DreamPawaret/GPS-Mobile-Robot-Project/project/6710.contentimage_5F00_112868.webp

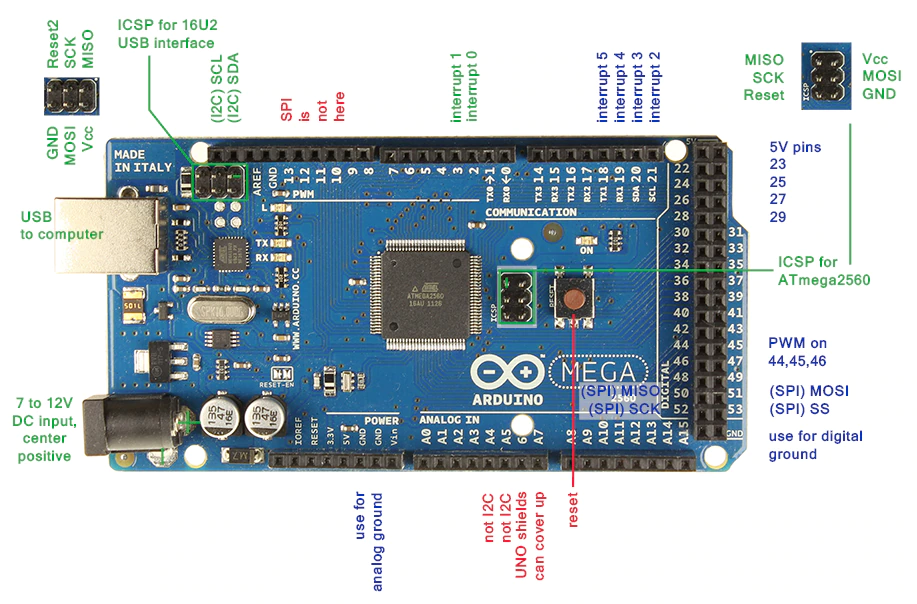
project/6710.contentimage_5F00_112868.webp
