DreamPawaret/GPS-Mobile-Robot-Project/project/รายงานความก้าวหน้า/complete report/GPS_mobile_robot.pdf

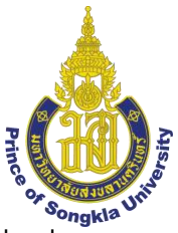
[picture p2: figure]

หุ่นยนต์เคลื่อนที่ควบคุมด้วยระบบ GPS GPS Mobile Robot

นายปวเรศ ปิ่นแก้ว
6010110680

โครงงานวิศวกรรมคอมพิวเตอร์นี้เป็นส่วนหนึ่งของการศึกษาตามหลักสูตรปริญญา วิศวกรรมศาสตร์บัณฑิต สาขาวิชาวิศวกรรมคอมพิวเตอร์ ภาควิชาวิศวกรรมคอมพิวเตอร์ คณะวิศวกรรมศาสตร์ มหาวิทยาลัยสงขลานครินทร์ 2565

ก

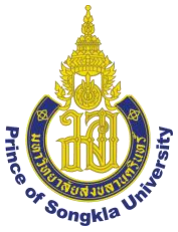
[picture p3: figure]

หุ่นยนต์เคลื่อนที่ควบคุมด้วยระบบ GPS GPS Mobile Robot

นายปวเรศ ปิ่นแก้ว
6010110680

โครงงานวิศวกรรมคอมพิวเตอร์นี้เป็นส่วนหนึ่งของการศึกษาตามหลักสูตรปริญญา วิศวกรรมศาสตร์บัณฑิต สาขาวิชาวิศวกรรมคอมพิวเตอร์ ภาควิชาวิศวกรรมคอมพิวเตอร์ คณะวิศวกรรมศาสตร์ มหาวิทยาลัยสงขลานครินทร์ 2565

ข

ชื่อโครงงาน | หุ่นยนต์เคลื่อนที่ควบคุมด้วยระบบ GPS
ผู้จัดท า | นายปวเรศ ปิ่นแก้ว | รหัสนักศึกษา | 6010110680
สาขาวิชา | วิศวกรรมคอมพิวเตอร์
ปีการศึกษา | 2565
อาจารย์ที่ปรึกษาโครงงาน | คณะกรรมการสอบ
(ผศ.ดร.ธเนศ เคารพาพงศ์) | (ดร.สมชัย หลิมศิโรรัตน์)
| (ดร.อนันต์ ชกสุริวงค์)
| (ผศ.ดร.นิคม สุวรรณวร)
| (ผศ.ดร.ธเนศ เคารพาพงศ์)

โครงงานนี้เป็นส่วนหนึ่งของรายวิชาโครงงานวิศวกรรมคอมพิวเตอร์ 1 และ 2 ตามหลักสูตร ปริญญาวิศวกรรมศาสตร์บัณฑิต สาขาวิชาวิศวกรรมคอมพิวเตอร์ มหาวิทยาลัยสงขลานครินทร์

(รศ.ดร.พิชญา ตัณฑัยย์)
รักษาการในหัวหน้าสาขาวิชาวิศวกรรมคอมพิวเตอร์

ค

หนังสือรับรองความเป็นเอกลักษณ์ ข้าพเจ้าผู้ลงนามท้ายนี้ ขอรับรองว่ารายงานฉบับนี้เป็นรายงานที่มีความเป็นเอกลักษณ์ โดยที่ ข้าพเจ้ามิได้มีการคัดลอกมาจากที่ใด เนื้อหาในรายงานทั้งหมดถูกรวบรวมจากการพัฒนาในขั้นตอน ต่าง ๆ ของการจัดท าโครงงาน หากส่วนใดที่จ าเป็นต้องน าข้อความจากผลงานของบุคคลอื่นใดที่ไม่ใช่ ตัวข้าพเจ้า ข้าพเจ้าได้ท าการอ้างอิงถึงเอกสารเหล่านั้นไว้อย่างเหมาะสม และขอรับรองว่ารายงาน ฉบับนี้ไม่เคยเสนอต่อสถาบันใดมาก่อน

ผู้จัดท า

(นายปวเรศ ปิ่นแก้ว)

ง

ชื่อโครงงาน | หุ่นยนต์เคลื่อนที่ควบคุมด้วยระบบ GPS
ผู้จัดท า | นายปวเรศ ปิ่นแก้ว | รหัสนักศึกษา | 6010110680
สาขาวิชา | วิศวกรรมคอมพิวเตอร์
ปีการศึกษา | 2565

บทคัดย่อ
เนื้อความบทคัดย่อ
โครงงานหุ่นยนต์เคลื่อนที่ควบคุมด้วยระบบ GPS เป็นโครงงานที่พัฒนาขึ้นเพื่อน าระบบระบุ ต าแหน่งบนโลก(GPS) มาประยุกต์ใช้กับหุ่นยนต์ โดยใช้การระบุพิกัดของ GPS ในการก าหนดพิกัดที่ ต้องการให้หุ่นยนต์เคลื่อนที่ไป เพื่อน าไปประยุกต์ในการใช้งานต่างๆภายนอกอาคาร เช่น การ ส่งพัสดุ หรือการส ารวจพื้นที่ โดยจะใช้หุ่นยนต์เคลื่อนที่อย่างง่าย ที่มีบอร์ด Arduino เป็นตัวหลักในการ ควบคุม สั่งการเซ็นเซอร์และการท างานของหุ่นยนต์เพื่อให้หุ่นยนต์เคลื่อนที่ไปโดยอัตโนมัติ

ค าส าคัญ ระบบระบุต าแหน่งบนโลก(GPS) มุมทิศ Haversine formular Azimuth formular

จ

Project | GPS Mobile Robot
Author | Mr. Pawaret Pinkaew Student ID | 6010110680
Major Program | Computer Engineering
Academic Year | 2022

Abstract
Description
GPS Mobile Robot is a project developed to apply global positioning system (GPS) to robots, using GPS coordinates to determine the target location that you want the robot to move. To be used in various applications outside the building such as parcel delivery or surveying the area, using a simple mobile robot that has an Arduino board as the main control and command the robot's sensors and actions to make the robot move automatically.

Keyword Global Positioning System (GPS) Azimuth angle Haversine formular
Azimuth formular

ฉ

กิตติกรรมประกาศ
โครงงานนี้ส าเร็จลุล่วงได้ด้วยความกรุณาจาก ผศ.ดร.ธเนศ เคารพาพงศ์ อาจารย์ที่ปรึกษา โครงงานที่ได้ให้ค าเสนอแนะ แนวคิด ตลอดจนการแก้ไขข้อบกพร่องต่าง ๆ มาโดยตลอดจนโครงงาน เล่มนี้เสร็จสมบูรณ์ ผู้จัดท าจึงขอกราบขอบพระคุณเป็นอย่างสูง
ขอบพระคุณ ผศ.ดร.นิคม สุวรรณวร ดร.อนันท์ ชกสุริวงค์ และ ดร.สมชัย หลิมศิโรรัตน์ ที่ให้ ค าแนะน าและข้อคิดต่ าง ๆ ในการจัดท าโครงงานฉบับนี้
ขอบพระคุณ คุณอนันต์ นิลโกสีย์ ที่ให้ค าแนะน าในการใช้งานเครื่องมือช่าง การเลือกวัสดุ และอุปกรณ์ที่ใช้งานในโครงงานและออ านวยความสะดวกในการใช้งานเครื่องมือ ขอบพระคุณคุณวิมล ค าจันทร์ คุณบงกช พฤกษพงษ์ที่อ านวยความสะดวกและค าปรึกษาใน การลงทะเบียนเรียนรายและการสอบวิชาโครงงาน
ขอบพระคุณผู้ปกครอง ที่ให้การสนับสนุน และขอขอบคุณพี่ๆรวมทั้งเพื่อน ๆ ที่ให้ความ ช่วยเหลือและให้ค าปรึกษาแนวท างในก ารท าโครงงานนี้

ปวเรศ ปิ่นแก้ว

ช

สารบัญ
หนังสือรับรองความเป็นเอกลักษณ์ | ค
บทคัดย่อ | ง
Abstract | จ
กิตติกรรมประกาศ | ฉ
สารบัญ | ช
สารบัญรูปภาพ | ญ
สารบัญตาราง | ฎ

ซ

ฌ

ญ

สารบัญรูปภาพ

ฎ

สารบัญตาราง

บทที่1
บทน า
ที่มาและความส าคัญ
ปัจจุบันหุ่นยนต์เริ่มเข้ามามีบทบาทในกิจกรรมต่างๆของมนุษย์มากขึ้น จึงมีการพัฒนาอย่าง รวดเร็วและ กว้างขวาง เพื่อช่วยแบ่งเบาภาระการท างานหรือเพิ่มประสิทธิภาพในการท างาน เช่น หุ่นยนต์บริการในร้านอาหาร BellaBot [1] ท าหน้าที่ให้บริการต้อนรับลูกค้า รับออร์เดอร์ และเสิร์ฟ อาหาร ซึ่งหุ่นยนต์ตัวนี้มีการใช้ AI ในการควบคุมเซ็นเซอร์หลายๆตัวเช่น การตรวจสอบการเคลื่อนไหว การระบุต าแหน่งภายในร้าน หากกล่าวถึงการระบุต าแหน่งแล้ว เทคโนโลยีที่มีความสามารถในการ ระบุต าแหน่งได้อย่างแม่นย าในปัจจุบันก็คือระบบ Global Positioning System (GPS) ซึ่งสามารถ น ามาประยุกต์ใช้เพื่อให้เกิดประโยชน์มากมายไม่ว่าจะ เป็น การท าแผนที่ ระบบน าร่อง หรือการ ติดตามยานพาหนะ อีกทั้งยังเป็นระบบที่ทุกคนสามารถเข้าถึงและใช้งาน ได้ง่าย ผู้จัดท าจึงมีความ สนใจที่จะน าระบบ GPS มาประยุกต์ใช้กับหุ่นยนต์ โดยใช้การระบุพิกัดของระบบ GPS มา ใช้ในการ ควบคุมทิศทางการเคลื่อนที่ของหุ่นยนต์เพื่อน าไปประยุกต์ในการใช้งานต่างๆภายนอกอาคาร เช่น การ ส่งพัสดุหรือการส ารวจพื้นที่ โดยจะใช้หุ่นยนต์เคลื่อนที่อย่างง่าย ที่มีบอร์ด Arduino เป็นตัวหลักใน การควบคุม และสั่งการเซ็นเซอร์ต่างๆของหุ่นยนต์

วัตถุประสงค์ของโครงงาน
1. เพื่อสร้างหุ่นยนต์ที่สามารถเคลื่อนที่ได้อัตโนมัติโดยใช้การระบุพิกัดด้วย GPS เป็นตัวควบคุม
2. เพื่อสร้างโปรแกรมในการก าหนดต าแหน่งเพื่อให้หุ่นยนต์เคลื่อนที่

ประโยชน์ที่คาดว่าจะได้รับ
1. สามารถสร้างหุ่นยนต์ที่สามารถเคลื่อนที่ได้อัตโนมัติตามต าแหน่งที่ระบุด้วยพิกัดจาก GPS ได้
2. สามารถสร้างโปรแกรมส าหรับการระบุต าแหน่งที่ต้องการให้หุ่นยนต์เคลื่อนที่ไปได้
3. สามารถน าการระบุพิกัด GPS ไปใช้ในการควบคุมทิศทางการเคลื่อนที่ของหุ่นยนต์ได้

ขอบเขตของโครงงาน
1. หุ่นยนต์สามารถเคลื่อนที่ได้ตามต าแหน่งที่ระบุบน GPS
2. หุ่นยนต์สามารถหลบสิ่งกีดขวางขนาดเล็กที่หยุดนิ่งได้
3. สามารถค านวณระยะทางและความเร็วในการเคลื่อนที่ศึกของหุ่นได้

แผนการด าเนินงาน
ขั้นตอนการด าเนินการ | Project Preparation (2/63) | Project I (1/64) | Project II (1/65)
ธ.ค. | ม.ค. | ก.พ. | มี.ค. | เม.ย. | มิ.ย. | ก.ค. | ส.ค. | ก.ย. | ต.ค. | มิ.ย. | ก.ค. | ส.ค. | ก.ย. | ต.ค.
1.ศึกษาหัวข้อโครงงาน
2.ศึกษางานวิจัยและเอกสารที่เกี่ยวข้องกับโครงงาน 3.ศึกษาระบบ GPS และระบบควบคุมที่ใช้ GPS 4.ศึกษาการท างานของอุปกรณ์และเซ็นเซอร์ต่างๆ ที่ใช้ในโครงงาน

5.ศึกษาการเขียนโปรแกรมส าหรับควบคุม microcontroller

6.ออกแบบหุ่นยนต์และระบบการท างาน 7.ออกแบบโปรแกรมและเขียนโปรแกรมส าหรับการท างาน ของ Microcontroller

8.พัฒนาหุ่นยนต์และเขียนโปรแกรมส าหรับควบคุม Microcontroller

9.ทดลองและวัดผลการทดลอง
10.สรุปผลการทดลอง
11.จัดท าเล่มโครงงาน
ตารางที่ 1 แผนการด าเนินงาน

บทที่2
ทฤษฎีและความรู้พื้นฐาน
GPS
GPS ย่อมาจาก Global Positioning System หรือระบบระบุต าแหน่งบนพื้นโลก โดยอาศัย ดาวเทียม ซึ่งโคจรอยู่รอบโลก ดาวเทียมดวงหนึ่งโคจรรอบโลก 1 รอบ ใช้เวลา 12 ขั่วโมง ระบบ GPS ท างานโดยการรับสัญญาณจากดาวเทียม ซึ่งประกอบไปด้วยประกอบไปด้วยข้อมูลที่ระบุต าแหน่งและ เวลาขณะส่งสัญญาณ เครื่องรับสัญญาณดาวเทียมจะค านวนระยะทางระหว่างดาวเทียมและเครื่องรับ สัญญาณ เพื่อความแม่นย าในการค านวณต าแหน่ง ต้องใช้ดาวเทียมอย่างน้อย 4 ดวง นอกจากนี้ความ แม่นย าของการระบุต าแหน่งนั้นขึ้นอยู่กับต าแหน่งของดาวเทียมแต่ละดวง ความแปรปรวนของชั้น บรรยากาศ และสิ่งแวดล้อมในบริเวณรับสัญญาณ [2][3]
ส่วนการควบคุมการน าทางของหุ่นยนต์

### 2.2.1 เครื่องรับสัญญาณ GPS GY-NEO6MV2

โมดูล GPS GY-NEO6MV2 เป็นโมดูล U-blox รุ่น NEO-6M สามารถเชื่อมต่อได้กับ ไมโครคอนโทรลเลอร์หลายหลายประเภทไม่ว่าจะเป็น Arduino, NodeMCU, Raspberry Pi, ESP32 ผ่านทาง Serial UART ความเร็วที่ 9600 (สามารถเพิ่มได้) และต าแหน่งอัพเดทตลอดทุกๆ 1 วินาที สามารถตั้งค่าให้เร็วกว่านี้ได้ การท างานเมื่อตัวโมดูลจับสัญญาณได้จะขึ้นไฟสีเขียวกระพริบ ตัวโมดูลมี แบตเตอรี่เก็บต าแหน่งล่าสุดและคอนฟิกต่างๆ โดยจะมีความแม่นย าของพิกัดอยู่ที่ 2.5 CEP หรือก็คือ ภายในรัศมี 2.5 เมตร [4]

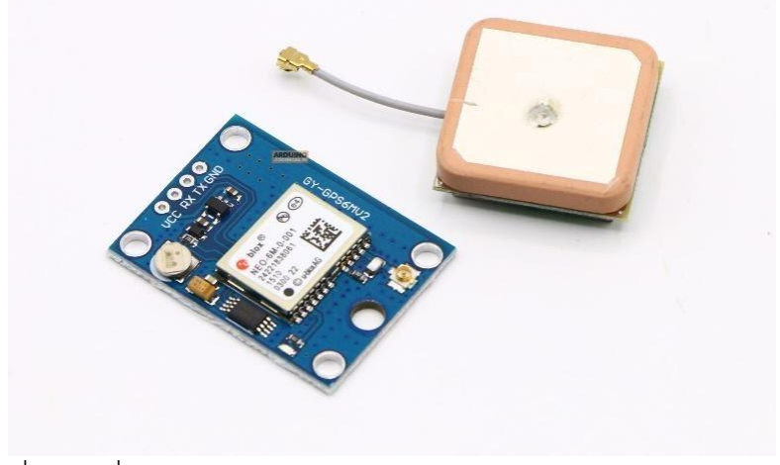
[picture p4: figure]

รูปที่ 1 เครื่องรับสัญญาณ GPS GY-NEO6MV2 และเสาอากาศ [5]

### 2.2.2 GY-273 3-axis Compass Module (HMC5883L)

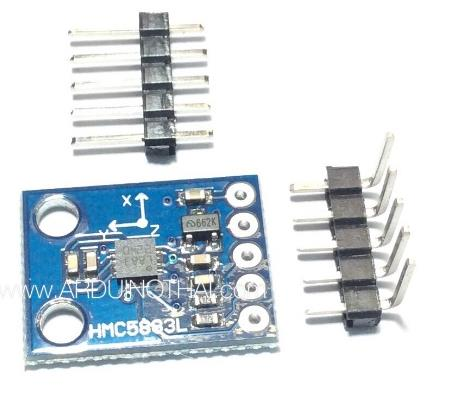
[picture p5: figure]

รูปที่ 2 GY-273 3-axis Compass Module (HMC5883L) [6]

เป็นโมดูลเข็มทิศ ใช้ชิป HMC5883L วัดสนามแม่เหล็ก 3 แกน สามารถประยุกต์ใช้งานเป็น เช็มทิศได้[7] มีความแม่นย าของเข็มทิศที่ 1-2 องศา [8]

### 2.2.3 BTS7960 H-Bridge DC Motor Drive (6-27V 47A Max) Module

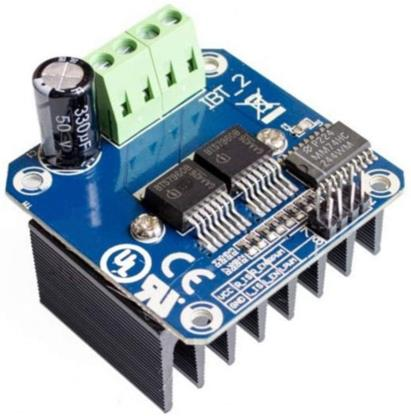
[picture p6: figure]

รูปที่ 3 Motor Drive Module BTS7960 [9]

ใช้ส าหรับขับดีซีมอเตอร์ที ่ต้องการกระแสสูงๆ ใช้สัญญาณ PWM ในการควบคุมความเร็ว รองรับความเร็ว ของ PWM ได้ถึง 25 KHz สามารถควบคุมมอเตอร์ได้ 1 ตัว และควบคุมหมุนซ้าย ขวา (กลับทาง)ได้ แรงดันไฟเลี้ยงมอเตอร์ : 6-27Vdc กระแสเอาต์พุตสูงสูง: 47A Max (ก าหนดจากส เปกของ BTS7960) ในทางปฏิบัติควรใช้กระแสไม่เกิน 20A เพื่อความปลอดภัย [10]

### 2.2.4 Shinano Kenshi DCG-5216-038

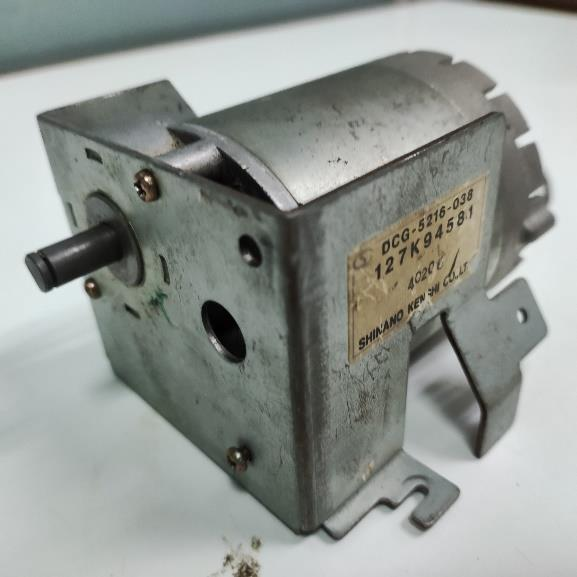
[picture p7: figure]

รูปที่ 4 Shinano Kenshi DCG-5216-038

เป็นมอเตอร์กระแสตรง รองรับแรงดันสูงสุดที่ 24 โวลต์ รองรับกระแสที่ 0.34 แอมป์ สูงสุดที่ 4 แอมป์โดยที่ไม่มีโหลด ความเร็วรอบอยู่ที่ 670 rpm และก าลัง 50 วัตต์

### 2.2.5 การค านวณทิศทางและมุมส าหรับการน าทาง

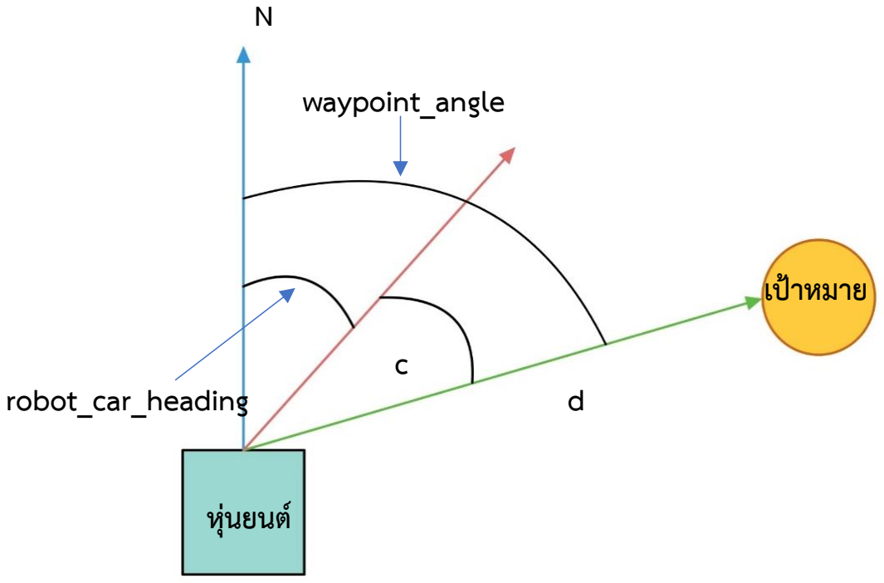
[picture p8: figure]
robot_car_heading; waypoint_angle; เป้าหมาย; หุ่นยนต์

รูปที่ 5 การค านวณทิศทางและมุมส าหรับการน าทาง

ในค านวณระยะทางระหว่างพิกัดที่หุ่นอยู่ ณ ปัจจุบันกับพิกัดจุดหมาย ใช้พิกัดละติจูด ลองจิจูด ของต าแหน ่ง 2 ต าแหน ่งในการค านวณ ใช้Haversine formular เป็นสมการในการค้นหา จาก สมการ

∆φ = φ2 − φ1

∆λ = λ2 − λ1

a = sin² (

∆φ
2

) + cos(φ1) ∙ cos(φ2) ∙ sin² (

∆λ
2

)

d = R ∙ 2 ∙ arctan2(√a, √1 − a)
เมื่อ ∅1 คือละติจูดของหุ่นยนต์ ∅2 คือละติจูดของเป้าหมาย
λ1 คือลองจิจูดของหุ่นยนต์
λ2 คือลองจิจูดของเป้าหมาย
R คือรัศมีของโลก (6317 km.) d คือระยะทางระหว่าง GPS 2 จุด ส าหรับการหามุมที่รถต้องหมุนไป(มุม c) เพื่อให้หันไปตรงกับพิกัดเป้าหมายหาได้จากสมการ c = waypoint_angle – robot_car_heading
robot_car_heading เป็นมุมตามเข็มนาฬิกาที่หุ่นยนต์ท ากับทิศเหนือหาได้จากการใช้โมดูลเข็มทิศ waypoint_angle เป็นมุมตามเข็มนาฬิกาที่เป้าท ากับทิศเหนือหาได้จาก Azimuth formular จาก สมการ

c = arctan2(sin(Δλ)cos(φ2

), cos(φ1

)sin(φ2

) − sin (φ1)cos (φ2)cos (Δλ))
ค่าที่ได้จากสมการมีทั้งบวกและลบขึ้นอยู่กับทิศของเป้าหมาย หากอยู่ฝั่งทิศเหนือจะมีค่าเป็น บวก หากอยู่ฝั่งทิศใต้จะมีค่าเป็นลบ จึงต้องน ามาบวกด้วย 360 เพื่อให้ได้มุมตามเข็มนาฬิกาที่เป้าท า กับทิศเหนือ

ส่วนการก าหนดพิกัดเป้าหมาย

### 2.3.1 Node MCU ESP8266

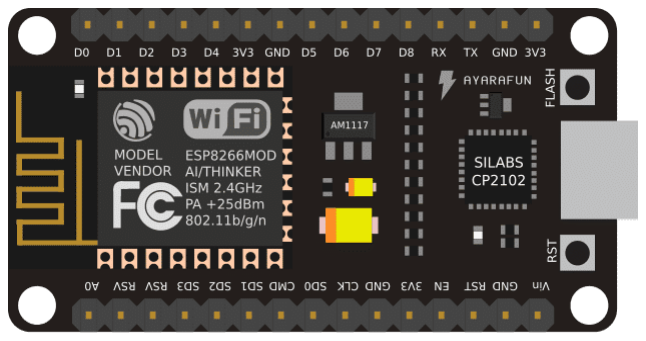
[picture p9: figure]

รูปที่ 6 NodeMCU ESP8266 [11] เป็นชื่อเรียกของชิฟของโมดูล ESP8266 ส าหรับติดต่อสื่อสารบนมาตรฐาน Wi-Fi ท างานที่ แรงดันไฟฟ้า 3.0-3.6V ท างานใช้กระแสโดยเฉลี่ย 80mA ภายในมี Low power MCU 32bit ท าให้ เราเขียนโปรแกรมสั่งงานโดยใช้ Arduino IDE ได้ มีวงจร analog digital converter ท าให้สามารถ อ่านค่าจาก analog ได้ความละเอียด 10bit [12]

### 2.3.2 การสื่อสารแบบอนุกรม

การสื่อสารแบบอนุกรม (Serial communication) คือ การใช้สาย 1 เส้นรับ-ส่งข้อมูล แบบต่อเนื่อง โดยอาศัยเทคนิคต่าง ๆ ในการสื่อสาร เช่นการใช้สัญญาณทริกเพื่อรับข้อมูลเข้า การใช้ บิตเริ่มต้นก าหนดการรับข้อมูล โดยอาจจะอาศัยและไม่อาศัยเวลาในการท างาน ทั้งนี้การสื่อสารแบบ อนุกรมสามารถแบ่งได้เป็น 2 รูปแบบคือ
1. แบบซิงโคนัส (Synchronous) – เป็นการสื่อสารที่ใช้สายสัญญาณข้อมูลอย่างน้อย 1 เส้น และมีสายอีก 1 เส้นก าหนดจังหวะการรับข้อมูล ข้อดีของการสื่อสารแบบนี้คือการรับส่ง ข้อมูลมีความผิดพลาดน้อยหรือไม่มีความผิดพลาดเลย แต่ข้อเสียคือต้องใช้สายสัญญาณอย่าง น้อย 2 เส้นในการสื่อสาร โดยโปรโตคอลที่ท างานแบบซิงโคนัสได้แก่ I2C I2S และ SPI
2. แบบอะซิงโคนัส (Asynchronous) – เป็นการสื่อสารที่ใช้สายสัญญาณข้อมูลเพียงเส้นเดียว ในการท างาน โดยอาศัยสัญญาณจากบิตเริ่มต้น และบิตสิ่นสุดในการบอกจังหวะการรับส่ง ข้อมูล การสื่อสารแบบนี้จ าเป็นต้องอาศัยเวลามาเป็นตัวก าหนดการรับสัญญาณเข้ามาซึ่งหาก มีการตั้งค ่าที ่ผิดจะท าให้อ่านข้อมูลที ่ส ่งมาได้ผิดพลาด ข้อดีของการสื ่อสารแบบนี้คือใช้ สายสัญญาณเพียง 1 เส้นก็สามารถรับ-ส่งข้อมูลได้แล้ว แต่ข้อเสียคือมีความผิดพลาดในการ สื่อสารได้ง่าย โดยโปรโตคอลที่ท างานแบบอะซิงโคนัสคือ UART [13]

### 2.3.3 Blynk

รูปที่ 7 Blynk Application [14]

Blynk เป็นแพลตฟอร์มแอฟพลิเคชั่นที่ช่วยให้สามารถสร้างอินเตอร์เฟซส าหรับควบคุมและ ตรวจสอบฮาร์ดแวร์โปรเจคได้จากอุปกรณ์ทั้ง IOS และ Android ได้อย ่างรวดเร็ว [15] โดยผู้ใช้ สามารถลากและวางเครื ่องมือ (widgets) ที ่มีให้เลือกใช้อย ่างมากมาย Blynk นั้นถูกออกแบบมา ส าหรับ Internet Of Things ท าให้สามารถควบคุมฮาร์ดแวร์ได้จากระยะไกล สามารถแสดงข้อมูล เซ็นเซอร์ จัดเก็บข้อมูล แสดงภาพ และท าสิ่งอื่นๆ ได้มากมาย รองรับอุปกรณ์ฮาร์ดแวร์ที่หลากหลาย ไม่ว่าจะเป็น Arduino NodeMCU หรือ Raspberry pi สามารถใช้งานได้ฟรี แต่จะจ ากัดเครื่องมือ หากต้องการใช้เครื่องมือนอกเหนือจากที่ให้บริการฟรี จะมีค่าใช้จ่ายเพิ่มเติม ส่วนการควบคุมการหลบสิ่งกีดขวาง

### 2.4.1 Ultrasonic sensor HC-SR04

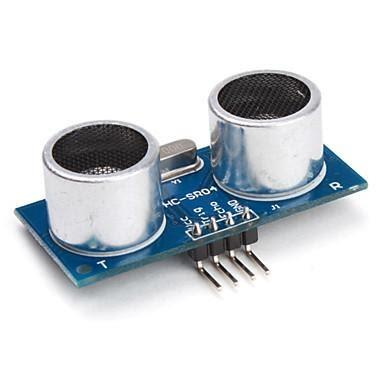
[picture p10: figure]

รูปที่ 8 Ultrasonic Sensor HC-SR04 [16]

เป็นโมดูลที่ใช้หาระยะห่างระหว่างวัตถุกับเซ็นเซอร์ โดยส่งสัญญาณอัลตร้าโซนิค ความถี่ 40 kHz ไปที่วัตถุที่ต้องการวัดและรับสัญญาณที่สะท้อนกลับมาพร้อมทั้งจับเวลาเพื่อน ามาใช้ในการ ค านวณระยะทาง [17]

อุปกรณ์และเทคโนโลยีอื่นๆที่ใช้

### 2.5.1 Arduino Mega 2560

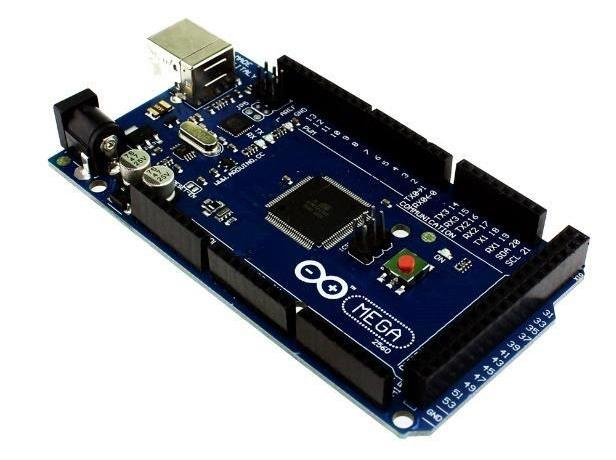
[picture p11: figure]

รูปที่ 9 Arduino Mega 2560 [18]

Arduino MEGA คือบอร์ดร ุ ่นใหญ ่ในกล ุ ่มบอร์ด Arduino โดยใช้ Atmega2560 เป็น ไมโครคอนโทรลเลอร์หลัก โดย Arduino MEGA มี Digital Pins ขา input/output digital จ านวน 54 ขา (เป็น PWM ได้ 15 ขา) มี Analog Input 16 ขา Serial UART 4 ชุด I2C 1 ชุด SPI 1 ชุด และ ขาแหล่งจ่ายไฟ 5V จ านวน 3 ขา สามารถเขียนโปรแกรมบน Arduino IDE และโปรแกรมผ่าน
USB [19]

### 2.5.2 Step down

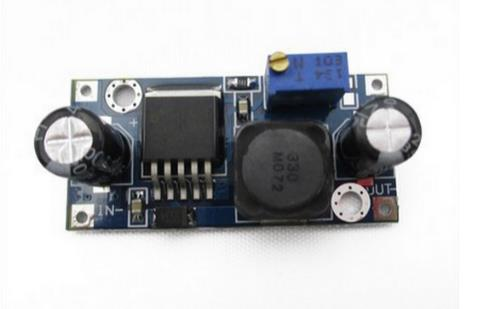
[picture p12: figure]

รูปที่ 10 Step down [20]

DC-to-DC Step Down LM2596 Module เป็นโมดูลแปลงไฟ DC Step Down (แปลงไฟ ลง) สามารถปรับค่าได้ตั้งแต่ 1.25-35V โดยปรับค่าที่ Potentiometer โมดูลสามารถจ่ากระแสได้ สูงสุด 3A [21]

### 2.5.3 Arduino IDE

Arduino IDE หรือชื่อเต็มคือ Arduino Integrated Development Environment เป็นชุด เครื่องมือส าหรับการเขียนโปรแกรมควบคุม Microcontroller เช่น Text editor ส าหรับการเขียน Code ตัว Compiler และอัปโหลดโปรแกรมลงบอร์ด Arduino [22]
แนวคิดการใช้งานโปรแกรม Arduino IDE
1. เขียนโปรแกรมด้วยภาษา C/C++
2. คอมไพล์โปรแกรมภาษา C/C++ เป็นภาษาส าหรับ Microcontroller และบันทึกเป็น Hex file
3. อัปโหลด Intel Hex File ลงบน Microcontroller ผ่านสาย USB

### 2.5.4 Shapr3D

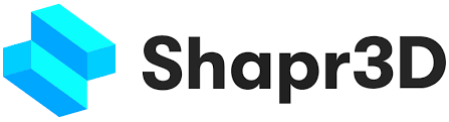
[picture p13: figure]

รูปที่ 11 Shapr3D [23]

Shapr3D เป็นเครื่องมือการสร้างแบบจ าลอง 3 มิติส าหรับการออกแบบทางกลไก สามารถใช้ งานได้ทั้ง IOS Android และ Windows บนอุปกรณ์ที่รองรับ

บทที่3
วิธีด าเนินงาน
แนวคิดในการออกแบบ
โครงงานนี้มีความต้องการที่จะสร้างหุ่นยนต์เคลื่อนที่อัตโนมัติ ด้วยน าระบบการระบุพิกัดบน พื้นโลกมาใช้ในการก าหนดต าแหน่งที่ต้อการให้แก่หุ่นยนต์ โดยในโครงงานจะใช้หุ่นยนต์รถขับเคลื่อน 2 ล้อ และมีล้อหมุนอิสระ 1 ล้อ
ภาพรวมของโครงงาน

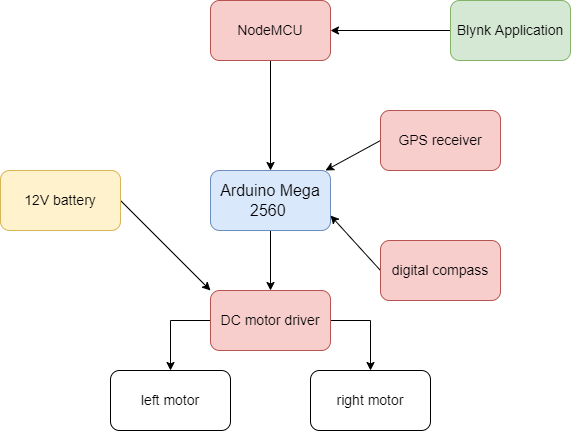
[picture p14: figure]

รูปที่ 12 ภาพรวมของโครงงาน

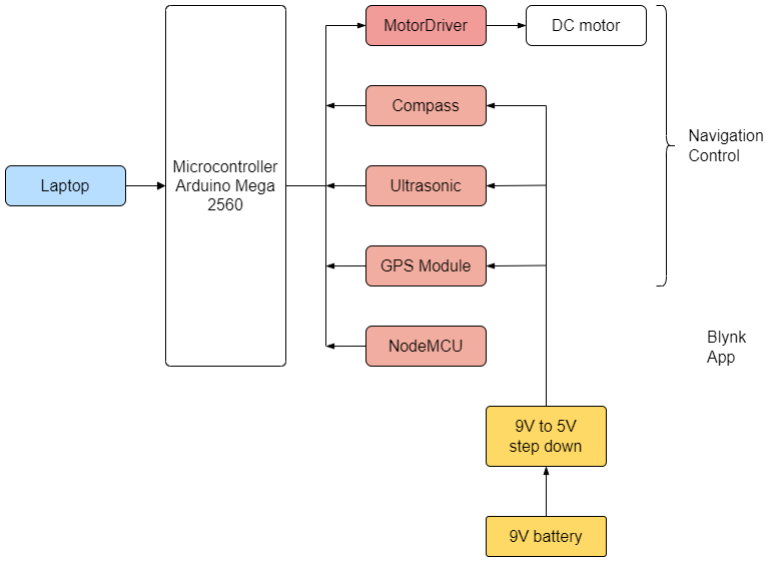
[picture p15: figure]

รูปที่ 13 ส่วนประกอบและการเชื่อมต่อของหุ่น

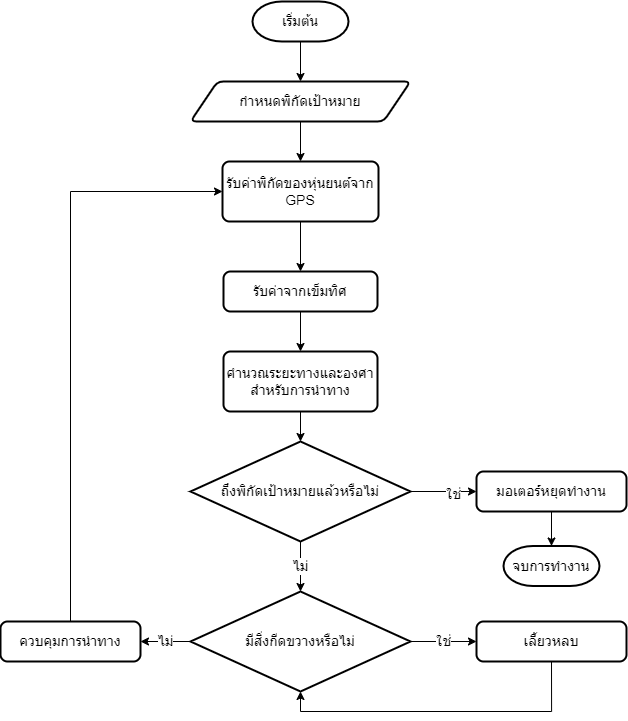
[picture p16: figure]

รูปที่ 14 การท างานของระบบ

ส่วนประกอบของโครงงาน
ส่วนประกอบของโครงงานสามารถแบ่งออกเป็น 3 ส่วน ได้แก่
1. ส่วนการก าหนดพิกัด
2. ส่วนควบคุมการน าทาง
3. ส่วนควบคุมการหลบสิ่งกีดขวาง
ออกแบบหุ่นยนต์
ออกแบบหุ่นยนต์เคลื่อนให้มีความเหมาะสมส าหรับการใช้งานภายนอกอาคาร โดยตัวหุ่นจะมี ขนาด 35 x 50 เซนติเมตร ใช้ล้อยางตันที่มีขนาดเส้นผ่านศูนย์กลาง 8 นิ้ว ใช้มอเตอร์ SHINANO KENSHI DCG-5216-038 ที่มีสามารถขับแรงดันได้สูงสุด 24V ในการขับเคลื่อนล้อ มีล้อหมุนอิสระ ข้างหน้า 1 ล้อเพื่อค ้าโครงสร้างของตัวหุ่น

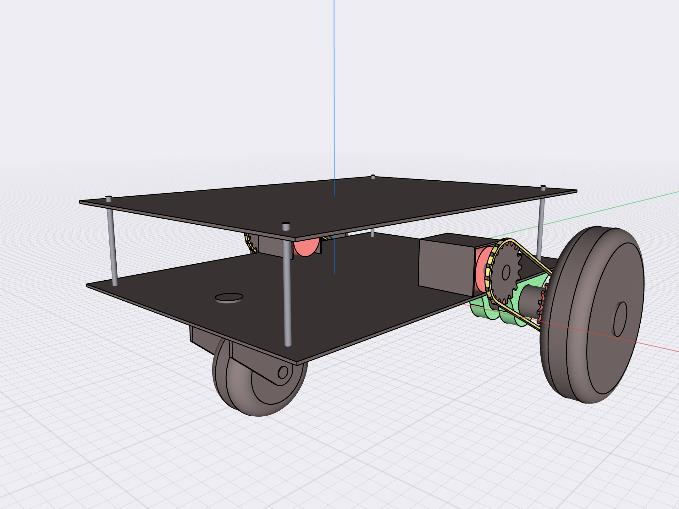
[picture p17: figure]

รูปที่ 15 โครงสร้างของหุ่นยนต์ที่ออกแบบ

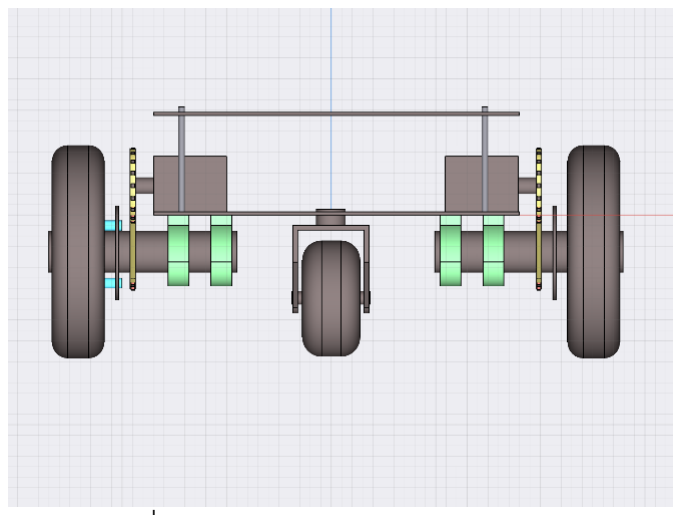
[picture p18: figure]

รูปที่ 16 มุมมองด้านหน้าของหุ่นยนต์

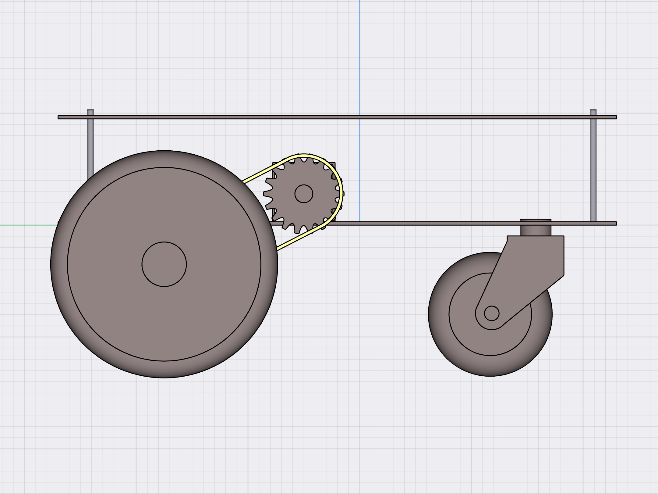
[picture p19: figure]

รูปที่ 17 มุมมองด้านข้างของหุ่นยนต์ที่ออกแบบไว้

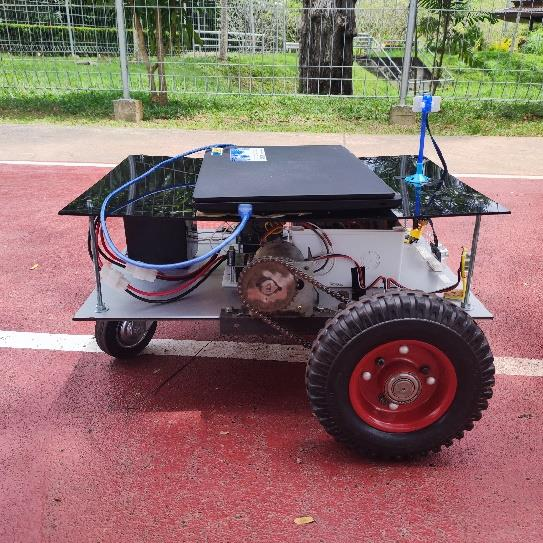
[picture p20: figure]

รูปที่ 18 มุมมองด้านข้างของหุ่นยนต์

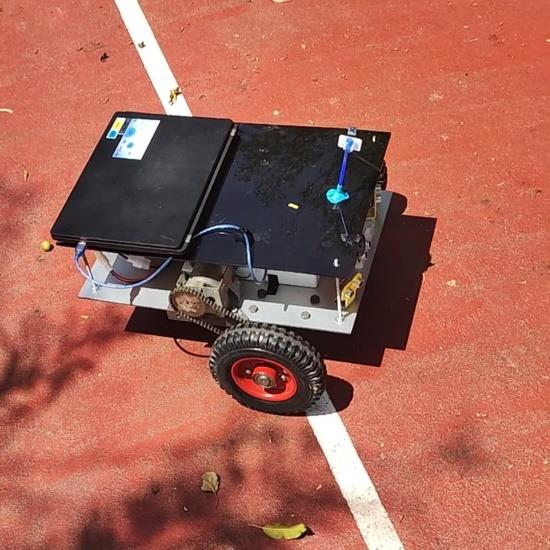
[picture p21: figure]

รูปที่ 19 มุมมองด้านบนของหุ่นยนต์

ส่วนการก าหนดพิกัด

### 3.5.1 แอพพลิเคชันที่ใช้

ในส่วนของการก าหนดพิกัดแก่หุ่นยนต์จะก าหนดผ่านการใช้แอพพลิเคชัน Blynk เพื่อส่ง ข้อมูลผ่านเครือข่ายเน็ตเวิร์คเข้าสู่บอร์ด Node MCU จากนั้นส่งข้อมูลไปยังบอร์ด Arduino Mega 2560 เพื่อน าไปใช้ในการค านวณหาเส้นทางในการเคลื่อนที่ของหุ่นยนต์

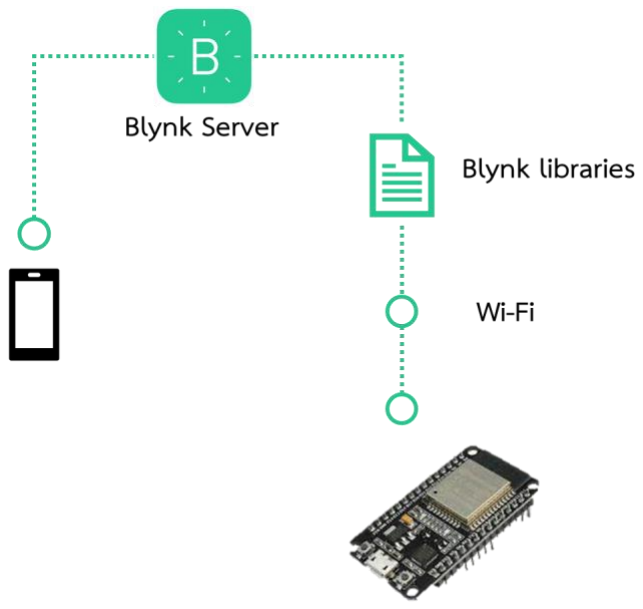
[picture p22: figure]

รูปที่ 20 การเชื่อมต่ออุปกรณ์กับ Blynk

การก าหนดพิกัดผ่าน Blynk

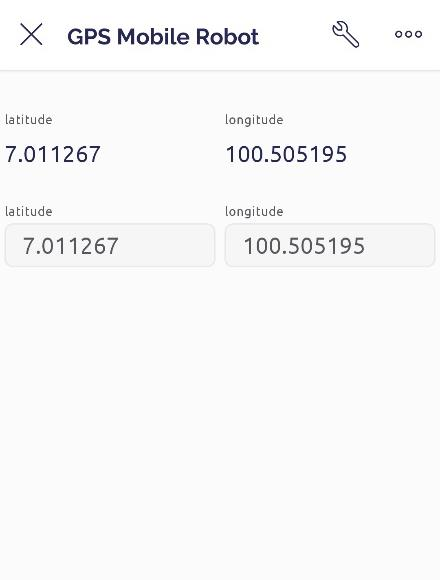
[picture p23: figure]

รูปที่ 21 การก าหนดพิกัดเป้าหมายแก่หุ่นยนต์ผ่าน Blynk latitude (text input): ส าหรับป้อนค่าละติจูดของพิกัด ใช้ทศนิยม 6 ต าแหน่ง
longitude (text input): ส าหรับป้อนค่าละจิจูดของพิกัด ใช้ทศนิยม 6 ต าแหน่ง โดยหลังจากป้อนค่าพิกัดแล้วจะต้องกด Enter บนแป้นพิมพ์เพื่อนเป็นการส่งค่าไปยังบอร์ด Node MCU

### 3.5.2 การส่งข้อมูลระหว่าง Arduino และ Node MCU

เชื่อมต่อ Arduino mega 2560 พิน 14(TX) และ 15(RX) เข้ากับ Node mcu ขาD2(RX) และ D1(TX) ตามล าดับ การรับส่งข้อมูลจะใช้การสื่อสารแบบอนุกรม(Serial) โดยที่ Node mcu จะเป็นตัว ส่งข้อมูลพิกัดที่ป้อนผ่าน Blynk application มายัง Arduino
เนื่องจากข้อจ ากัดของตัวแปรประเภท float ที่ใช้ในการเก็บค่าพิกัดละติจูดและลองจิจูด ใน เรื่องของขนาดของข้อมูลและความแม่นย าของต าแหน่งทศนิยม ก่อนการส่งข้อมูลจึงคูณค่าพิกัดด้วย 1000000 เพื่อให้ต าแหน่งทศนิยมที่ใช้มาเป็นจ านวณเต็ม จากนั้นเมื่อ Arduino รับข้อมูลมา จะน า ข้อมูลนั้นมาหารด้วย 100000 เพื่อให้เหลือทศนิยมต าแหน่งที่ต้องการ รูปด้านล่างแสดง Serial Monitor ของบอร์ด Arduino ที่แสดงข้อมูลพิกัดที่ได้รับมาจากบอร์ด Node MCU

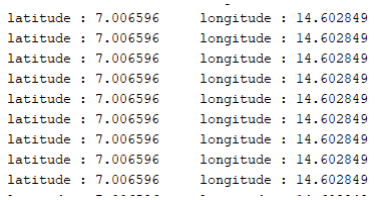
[picture p24: figure]

รูปที่ 22 ข้อมูลที่ยังไม่ได้คูณด้วย 1000000 ก่อนการส่ง

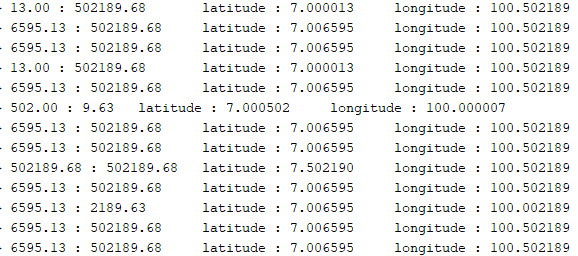
[picture p25: figure]

รูปที่ 23 ข้อมูลที่คูณด้วย 1000000 ก่อนการส่งแล้ว

ส่วนการควบคุมการน าทาง

### 3.6.1 Navigation vector

เพื่อให้หุ่นยนต์สามารถเคลื่อนที่ไปยังพิกัดที่ก าหนดได้ จะใช้ระยะทาง และมุมที่ต้องเคลื่อนที่ใน การน าทาง และเพื่อให้รู้ค่าดังกล่าว จะใช้ค่าพารามิเตอร์ 3 ตัวคือ พิกัดเป้าหมาย พิกัดของหุ ่นยนต์ และทิศทางของหัวหุ่นยนต์ที่สัมพันธ์กับเหนือ(robot_car_heading) ซึ่งได้จากโมดูลเข็มทิศและโมดูล GPS

### 3.6.2 Navigation control

ในการควบคุมส าหรับการน าทางนั้น ก่อนอื่นต้องลดความคลาดเคลื่อนของทิศทางการมุ่งหน้า ไปยังพิกัดเป้าหมายโดยหันหุ่นยนต์ไปทางขวาหากค่าความคลาดเคลื่อนเป็นบวก และหันไปทางซ้าย หากค่าความคลาดเคลื่อนเป็นลบ ผู้จัดท าโครงงานได้ก าหนดช ่วงของความคลาดเคลื่อนไว้ที่ ±10 องศา
เนื่องจากเป็นเรื่องยากที่จะลดค ่าความคลาดเคลื่อนให้เหลือศูนย์ ในขณะเดียวกันก็ต้องลด ความคลาดเคลื่อนของระยะทางโดยการให้หุ่นยนต์เคลื่อนที่ไปข้างหน้าในทิศทางที่ใกล้เคียงกับพิกัด เป้าหมาย แต่การเคลื่อนที่ไปข้างหน้านั้นจะท าให้ค่าความคลาดเคลื่อนของทิศทางการเคลื่อนที่มีค่า เพิ่มขึ้นทั้งในทางบวกและทางลบ จึงต้องมีการท าซ ้าไปเรื่อยๆในการค านวณ navigation vector และ การควบคุมการน าทางเพื ่อลดค ่าความคลาดเคลื ่อนทั้งสองให้เหลือน้อยที ่สุดจนกว ่าหุ ่นยนต์จะ เคลื่อนที่ไปยังพิกัดเป้าหมายได้โดยเมื่อหุ่นยนต์เคลื่อนที่ไปอยู่ในรัศมีประมาณ 1-3 เมตรของพิกัด เป้าหมายจะถือว่าสามารถเคลื่อนที่ไปยังพิกัดเป้าหมายได้ส าเร็จ
ส าหรับเส้นทางในการเคลื่อนที่ของหุ่นยนต์นั้น จะเป็นเส้นทางตรงไปยังพิกัดเป้าหมาย คือใช้ ต าแหน่ง ณ ปัจจุบันของตัวหุ่นยนต์เป็นจุดอ้างอิงในการหาเส้นทางในการเคลื่อนที่ ดังนั้นเมื่อหุ่นยนต์ มีการเลี้ยวหรือเคลื่อนที่ออกนอกทิศทางของการเคลื่อนที่ เส้นทางการเคลื่อนที่จะเปลี่ยนไปเสมอ แต่ ทุหเส้นทางจะเป็นระยะกระจัดจากหุ่นยนต์ถึงพิกัดเป้าหมาย

### 3.6.3 การทดสอบส่วนควบคุมการน าทาง

ทดสอบโดยการให้หุ่นยนต์เคลื่อนที่ไปยังพิกัดที่ก าหนด โดยใช้พิกัดเดิมทุกครั้งในการเคลื่อนที่ บันทึกระยะห่างระหว่างพิกัดเป้าหมายกับพิกัดที่หุ่นยนต์เคลื่อนที่ไปถึง หากอยู่ในระยะ 3 เมตรถือว่า ถึงพิกัดเป้าหมายแล้ว (ค่าความแม่นย าของ GPS อยู่ในระยะ 2.5 เมตร)

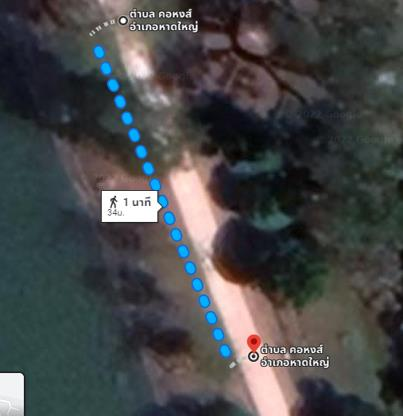
[picture p26: figure]

รูปที่ 24 พื้นที่ส าหรับการทดสอบส่วนควบคุมการน าทาง

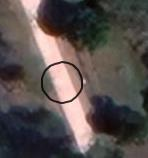
[picture p27: figure]

รูปที่ 25 พื้นที่ที่หุ่นยนต์ต้องเคลื่อนที่ไป

ส่วนการควบคุมการหลบสิ่งกีดขวาง
ใช้ ultrasonic sensor 3 ตัวติดตั้งไว้มุมซ้าย ขวา และตรงกลางบริเวณด้านหน้าของหุ่นยนต์ เพื่อใช้ในการตรวจจับวัตถุ หากเซ็นเซอร์ตัวใดตัวหนึ่งตรวจจับเจอวัตถุในระยะ 50 เซนติเมตร จะ ควบคุมให้หุ่นยนต์เลี้ยวหลบสิ่งกีดขวาง ทิศทางของการเลี้ยวนั้นจะขึ้นอยู่กับว่าเซ็นเซอร์ตัวใดตรวจจับ เจอวัตถุ หากเซ็นเซอร์ทางขวาตรวจเจอก็จะแล้วซ้าย หากเซ็นเซอร์ตรงกลางหรือทางซ้ายตรวจเจอก็ จะเลี้ยวขวา
ใช้ interrupt แทนการใช้ if else เช็คเงื่อนไขการท างานของ ultrasonic sensor ในการ ตรวจจับวัตถุ หากเซ็นเซอร์มีการเปลี่ยนแปลง จะขัดจังหวะการท างานของโปรแกรม ไปท าตามค าสั่ง

ในฟังก์ชันของ interrupt service routine แทน และหากมีวัตถุอยู่ในระยะที่ก าหนด จะควบคุมให้ หุ่นยนต์เลี้ยวหลบสิ่งกีดขวาง

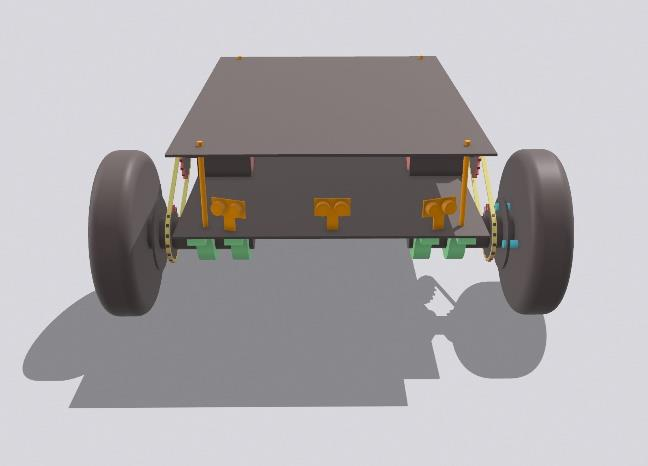
[picture p28: figure]

รูปที่ 26 ภาพจ าลองการติดตั้ง ultrasonic sensor

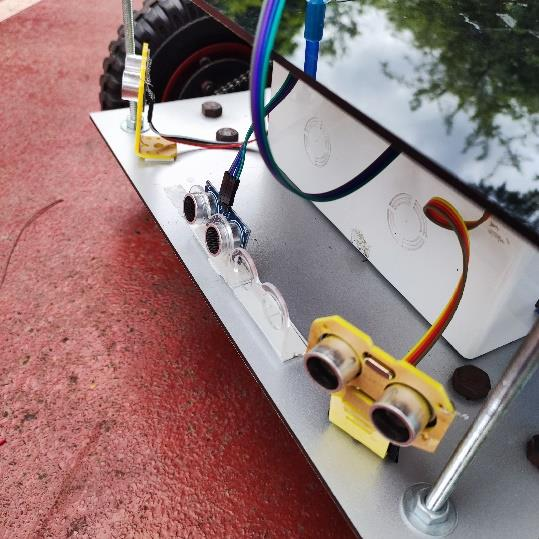
[picture p29: figure]

รูปที่ 27 การติดตั้ง ultrasonic sensor

### 3.7.1 แนวคิดในการเขียนโปรแกรมการใช้งาน Interrupt กับ Ultrasonic

การใช้งาน interrupt กับ ultrasonic นั้นคล้ายกับการใช้งาน ultrasonic ทั่วไป แต่จะต้องมี ขาส าหรับรับสัญญาณเมื่อมีการเกิด interrupt โดยจะก าหนดรูปแบบการเกิด interrupt คือ CHANGE โดย library ที่ใช้ในการสร้าง interrupt คือ TimerOne.h [ ]และมีฟังก์ชันดังนี้ trigger_pulse(); จะถูกเรียกทุกๆ 50 µs เพื่อใช้ในการสร้าง trigger pulse ทุกๆ 4000 pulse echo_interrupt(); ถูกเรียกทุกครั้งที่สัญญาณเข้าขา echo เปลี่ยนสถานะ โดยใช้สัญญาณเข้าจากขา echo พิจารณาจุดเริ่มต้นและสิ้นสุดของเสียงสะท้อน และเวลาเริ่มต้นและสิ้นสุดของสัญญาณ ถ้า input เปลี่ยนจากสูงไปต ่าแสดงว่าสัญญาณ pulse สิ้นสุด และค านวณระยะทาง

บทที่4
ผลและวิเคราะห์ผล
จากวิธีการด าเนินงานที่กล่าวไปแล้วในบทที่ 3 จะแบ่งการทดสอบระบบอกเป็น 3 ส่วนคือ ส่วนการก าหนดพิกัด ส่วนการควบคุมการน าทาง และส่วนการควบคุมการหลบสิ่งกีดขวาง ส่วนการก าหนดพิกัด
จากการทดสอบการก าหนดพิกัดเป้าหมายแก่หุ่นยนต์นั้น สามารถก าหนดพิกัดละติจูดและ ลองจิจูดผ่าน Blynk ไปยังบอร์ด Node MCU ได้ และสามารถส่งข้อมูลที่ได้รับมาจากบอร์ด Node MCU ไปยังบอร์ด Arduino ได้
ในการรับส่งข้อมูลนั้น เมื่อรับส่งข้อมูลไปได้ระยะเวลาหนึ่ง พิกัดละติจูดและลองติจูดที่ได้รับจะ สลับต าแหน่งกันและค่าพิกัดคลาดเคลื่อนไปเยอะมาก จึงต้องใส่ prefix ก่อนการส่งข้อมูล นั่นคือก่อน การส่งข้อมูลจะบวก 1000000 ส าหรับค่าละติจูด และ บวก 2000000 ส าหนับค่าลองจิจูด เพื่อใช้ใน การตรวจสอบว่า ข้อมูลที่ได้รับมานั้นเป็นพิกัดละติจูดหรือลองจิจูด

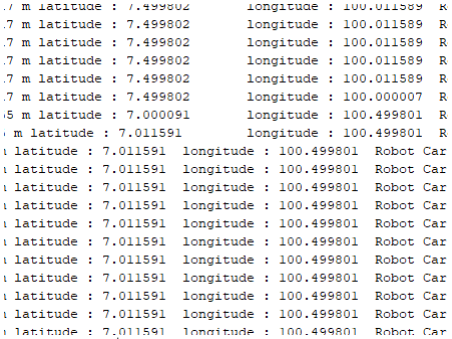
[picture p30: figure]

รูปที่ 28 การรับส่งค่าพิกัดก่อนใส่ prefix

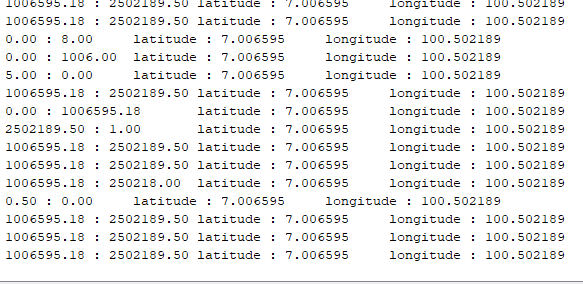
[picture p31: figure]

รูปที่ 29 การรับส่งพิกัดหลังการใส่ prefix

หลังจากใส่ prefix ในการส่งข้อมูลแล้ว เมื่อตรวจสอบแล้วว่าข้อมูลที่รับมาถูกต้อง จะอัพเดท ข้อมูลพิกัด หากข้อมูลที่รับมาไม่ถูกต้อง ก็จะไม่มีการเก็บข้อมูลในตัวแปรนั้น

ส่วนควบคุมการน าทาง
จากการทดสอบส่วนควบคุมการน าทางของหุ่นยนต์ที่ได้ออกแบบไว้หุ่นยนต์สามารถเคลื่อนที่ ไปยังพิกัดที่ก าหนดไว้ได้ โดยระยะห่างเฉลี่ยระหว่างพิกัดเป้าหมายกับพิกัดที่หุ่นยนต์เคลื่อนที่ไปถึงทั้ง 10 ครั้ง อยู่ที่ 2.390 เมตร

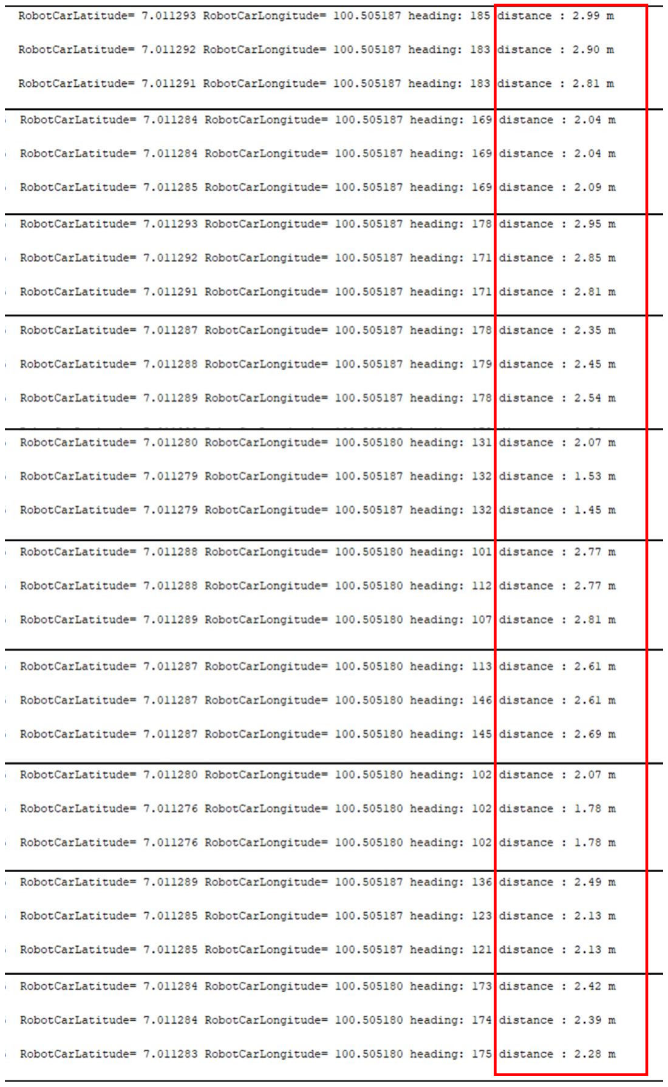
[picture p32: figure]

รูปที่ 30 ผลจากการทดสอบการควบคุมการน าทาง 10 ครั้ง

ส่วนควบคุมการหลบสิ่งกีดขวาง
จากการทดสอบส่วนควบคุมการหลบสิ่งกีดขวาง หุ่นยนต์สามารถหลบสิ่งกีดขวางซึ่งหยุดนิ่ง อยู่หน้าหน้าตัวหุ่นยนต์ได้ โดยเมื่อเซนเซอร์ตรวจพบวัตถุในระยะ 50 เซนติเมตร โปรแกรมในลูปของ หุ่นยนต์จะถูกขัดจังหวะ แล้วไปท างานในส่วนของ interrupt service routine แทน เพื่อควบคุมให้ หุ่นยนต์หลบสิ่งกีดขวางนั้นๆตามที่ได้โปรแกรมไว้

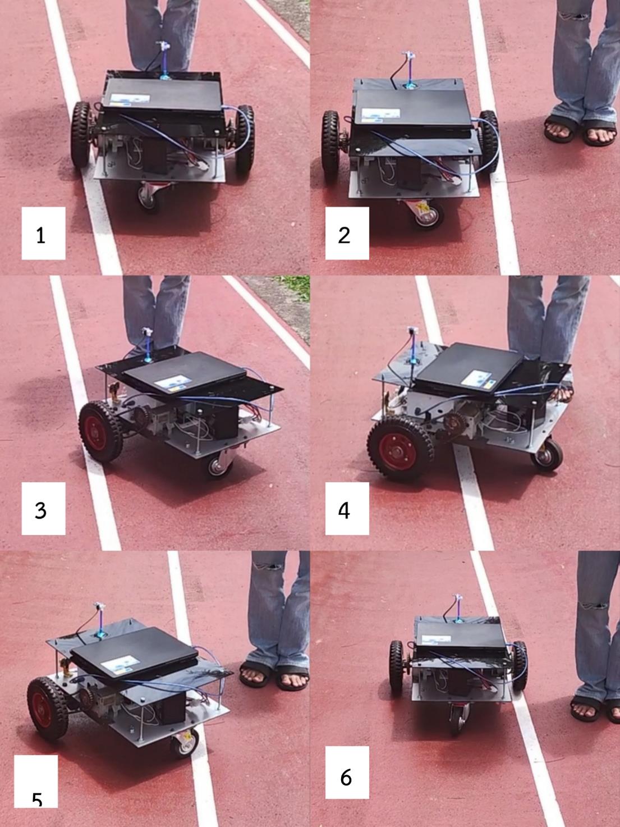
[picture p33: figure]

รูปที่ 31การหลบสิ่งกีดขวางของหุ่นยนต์ แสดงตามล าดับตัวเลข

สรุปผล
จากการท างานของระบบในภาพรวม ส่วนของการก าหนดพิกัด เริ่มเมื่อบอร์ด Node MCU และอุปกรณ์ที่ติดตั้ง Blynk มีการเชื่อมต่อเครือข่าย Wi-Fi เลือกพิกัดเป้าหมายที่ต้องการให้หุ่นยนต์ เคลื่อนที่ไป (สามารถดูได้จาก google map) จากนั้นป้อนค่าพิกัดละติจูลและลองจิจูดผ่านทาง Blynk สามารถก าหนดพิกัดเป้าหมายให้หุ่นยนต์ได้
จากการท างานของระบบในภาพรวม ส่วนควบคุมการน าทาง เมื่อบอร์ด Arduino รับข้อมูล มาจากบอร์ด Node MCU แล้ว จะน าค่าที่ได้มาค านวณหามุมและระยะทางในการเคลื่อนที่ร ่วมกับ ค ่าที ่ได้จากโมดูลเข็มทิศและโมดูล GPS จากนั้นน าค ่าที ่ได้มาเช็คว ่าหุ ่นยนต์อยู ่ในรัศมีของพิกัด เป้าหมายหรือไม่ หากไม่ได้อยู่ในรัศมีของพิกัดเป้าหมายที่ก าหนดไว้ ก็จะควบคุมมอเตอร์ให้หมุน เพื่อให้หุ่นยนต์เคลื่อนที่ไปยังพิกัดนั้น
จากการท างานของระบบในภาพรวม ส่วนควบคุมการหลบสิ่งกีดขวาง เมื่อเซนเซอร์ตรวจพบ วัตถุในระยะ 50 เซนติเมตร มอเตอร์จะหยุดท างาน จากนั้นจะท าการควบคุมให้หุ่นยนต์หลบสิ่งกีด ขวางนั้นๆตามที่ได้อธิบายไว้แล้วในบทที่ 3
วิเคราะห์ผล
จากผลการทดลองที ่กล ่าวมาแล้วในข้างต้นสรุปได้ว ่า สามารถก าหนดพิกัดเป้าหมายแก่ หุ่นยนต์ได้ แต่เนื่องจากข้อจ ากัดของตัวแปรประเภท float ที่ใช้ในการเก็บค่าในเรื่องของขนาดข้อมูล และความแม ่นย าของต าแหน ่งทศนิยม ท าให้ในบางครั้งพิกัดที ่ก าหนดให้แก ่หุ ่นยนต์มีความ คลาดเคลื่อนเล็กน้อย ดังนั้นระยะทางของเส้นทางที่หุ่นยนต์ต้องเคลื่อนที่จึงคลาดเคลื่อนไปน้อยกว่า 0.3 เมตรจากการค านวณ แต่หุ่นยนต์ยังสามารถเคลื่อนที่ไปยังพิกัดที่ก าหนดได้

บทที่5
สรุปและข้อเสนอแนะ
สรุป
จากการออกแบบและขั้นตอนในการพัฒนาระบบ ท าให้น าไปสู่ผลงานที่สามารถท าได้ตาม เป้าหมายขอบเขตที่วางไว้ โดยมีอุปสรรคที่พบได้แก่การรับส่งข้อมูลที่มีความคลาดเคลื่อนอยู่เล็กน้อย และข้อจ ากัดของ library ที่น ามาใช้งาน แต่อย่างไรก็ตาม ในภาพรวมถือว่าสามารถบรรลุเป้าหมายที่ วางไว้โดยจากการพัฒนาระบบที่ผ่านมาสามารถสรุปการท างานโดยรวมของระบบได้ดังนี้
1. สามารถก าหนดพิกัดเป้าหมายให้แก่หุ่นยนต์ได้ผ่านทาง Blynk application
2. สามารถส่งข้อมูลระหว่าง Arduino และ Node MCU โดยใช้การสื่อสารแบบอนุกรมได้
3. รับค่าพิกัดจากโมดูล GPS และเข็มทิศเพื่อน ามาใช้ในการค านวณระยะทางและมุม
4. ค านวณเวกเตอร์ส าหรับการน าทาง คือระยะทางและมุมเพื่อน าไปใช้ในการควบคุมการน า ทางของหุ่นยนต์จากพิกัดเป้าหมาย พิกัดของหุ่นยนต์ และทิศทางของหัวหุ่นยนต์ที่สัมพันธ์ กับเหนือ
5. หุ่นยนต์สามารถเคลื่อนที่ไปยังพิกัดเป้าหมายได้โดยใช้เวกเตอร์ส าหรับการน าทางมาใช้ใน การหาเส้นทางการเคลื่อนที่
6. ควบคุมการหมุนของมอเตอร์ เพื่อควบคุมการเคลื่อนที่ของหุ่นยนต์ตามเวกเตอร์ส าหรับการ น าทางที่ได้จากการค านวณ
7. หุ่นยนต์สามารถหลบสิ่งกีดขวางซึ่งหยุดนิ่งในระยะ 50 เซนติเมตรจากตัวหุ่นยนต์ได้ ข้อเสนอแนะ
1. ก่อนการใช้งาน ผู้ใช้จะต้องเชื่อมต่อเครือข่ายอินเตอร์เน็ตกับบอร์ด Node MCU และ อุปกรณ์ที่ติดตั้งแอพพลิเคชั้น Blynk แต่เนื่องจาก Wi-Fi ของมหาวิทยาลัยที่เป็บแบบ 802.1x ท าให้ค่อนข้างล าบากต่อการเชื่อมต่อกับบอร์ด Node MC จึงใช้การเชื่อมต่อกับ Hotspot จากมือถือ
2. ในระหว่างการเคลื่อนที่ของหุ่นยนต์นั้น ในบางครั้งล้อหมุนอิสระที่ใช้ในการค ้าโครงสร้าง ของหุ่นยนต์ไม่สามารถหมุนได้หรือแรงของมอเตอร์ไม่เพียงพอ จีงต้องใช้มือในการดัน หุ่นนต์เพื่อให้ล้อสามารถหมุนได้
3. การติดตั้งโมดูลเข็มทิศ จ าเป็นต้องติดตั้งให้สูงขึ้นมาและให้ห่างจากอุปกรณ์อื่นๆ เพื่อ ป้องกันสนามแม่เหล็กรบกวนซึ่งอาจจะท าให้ทิศที่ได้มีความคลาดเคลื่อน
4. ในระหว่างการใช้งานหุ่นยนต์ ต้องเชื่อมต่ออุปกรณ์แล็ปท็อปเพื่อแสดงผลผ่านทาง serial monitor เนื่องจากใช้งานและทดสอบช่วงเวลากลางวัน จึงไม่ควรใช้งานเป็นเวลานานๆ เพราะท าให้เกิดความร้อนแก่อุปกรณ์ได้

บรรณานุกรม
[1] Sunrobotics. “BellaBot,” [Online]. https://www.sunrobotics.co.th/th/articles/202731-bellabot-หุ่นยนต์บริการ-(-service-robot-)-หุ่นยนต์แมวน้อยเสิร์ฟอาหาร-ถูกออกแบบมาให้เหมือนเเมวน้อยน่ารัก-cute-สุดๆ (https://www.sunrobotics.co.th/th/articles/202731-bellabot-หุ่นยนต์บริการ-(-service-robot-)-หุ่นยนต์แมวน้อยเสิร์ฟอาหาร-ถูกออกแบบมาให้เหมือนเเมวน้อยน่ารัก-cute-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) . [Accessed Jan. 9, 2021].
[2] global5thailand. “ความรู้ทั่วไปเกี่ยวกับ GPS,” [Online]. https://global5thailand.com/thai/gps.htm [Accessed Jan. 9, 2021].
[3] Garmin ประเทศไทย. “GPS คืออะไร,” [Online]. https://www.garmin.com/th-TH/aboutgps/. (https://www.garmin.com/th-TH/aboutgps/) [Accessed Jan. 9, 2021].
[4] IoT code mobiles. “GY-NEO6MV2 GPS module,” [Online]. http://www.iot.codemobiles.com/product/296/gy-neo6mv2-gps-module-neo6mv2-with-gps-antenna. (http://www.iot.codemobiles.com/product/296/gy-neo6mv2-gps-module-neo6mv2-with-gps-antenna) [Accessed Fab. 15, 2021].
[5] IoT code mobiles. “GY-NEO6MV2 GPS module,” [Online]. http://www.iot.codemobiles.com/product/296/gy-neo6mv2-gps-module-neo6mv2-with-gps-antenna. (http://www.iot.codemobiles.com/product/296/gy-neo6mv2-gps-module-neo6mv2-with-gps-antenna) [Accessed Fab. 15, 2021].
[6] Analog Read. “GY-273 3-axis Compass Module,” [Online]. https://www.analogread.com/product/446/gy-273-3-axis-compass-module-hmc5883l. (https://www.analogread.com/product/446/gy-273-3-axis-compass-module-hmc5883l) [Accessed Fab. 28, 2021].
[7] Analog Read. “GY-273 3-axis Compass Module,” [Online]. https://www.analogread.com/product/446/gy-273-3-axis-compass-module-hmc5883l. (https://www.analogread.com/product/446/gy-273-3-axis-compass-module-hmc5883l) [Accessed Feb. 28, 2021].
[8] Honeywell. “3-Axis Digital Compass IC HMC5883L,” [Online]. https://cdn-shop.adafruit.com/datasheets/HMC5883L_3-Axis_Digital_Compass_IC.pdf. (https://cdn-shop.adafruit.com/datasheets/HMC5883L_3-Axis_Digital_Compass_IC.pdf) [Accessed Aug. 27, 2022].
[9] Arduino4. “BTN7960 BTS7960 43A Current Limiting High-Power H-Bridge DC Motor Drive Module,” [Online]. https://www.arduino4.com/product/844/btn7960-bts7960-43a-current-limiting-high-power-h-bridge-dc-motor-drive-module-โมดูขับ-motor-dc. (https://www.arduino4.com/product/844/btn7960-bts7960-43a-current-limiting-high-power-h-bridge-dc-motor-drive-module-โมดูขับ-motor-dc) [Accessed Feb. 28, 2021].
[10] Arduino4. “BTN7960 BTS7960 43A Current Limiting High-Power H-Bridge DC Motor Drive Module,” [Online]. https://www.arduino4.com/product/844/btn7960-bts7960-43a-current-limiting-high-power-h-bridge-dc-motor-drive-module-โมดูขับ-motor-dc. (https://www.arduino4.com/product/844/btn7960-bts7960-43a-current-limiting-high-power-h-bridge-dc-motor-drive-module-โมดูขับ-motor-dc) [Accessed Feb. 28, 2021].
[11] Allnewstep. “NodeMCU ESP8266,” [Online]. https://www.allnewstep.com/article/30/nodemcu-esp8266-esp8285-arduino-1-esp8266-คือ (https://www.allnewstep.com/article/30/nodemcu-esp8266-esp8285-arduino-1-esp8266-คือ) . [Accessed Feb. 15, 2021].
[12] Allnewstep. “NodeMCU ESP8266,” [Online]. https://www.allnewstep.com/article/30/nodemcu-esp8266-esp8285-arduino-1-esp8266-คือ (https://www.allnewstep.com/article/30/nodemcu-esp8266-esp8285-arduino-1-esp8266-คือ) . [Accessed Feb. 15, 2021].
[13] Artronshop. “ESP32 เบื้องต้น :: บทที่ 7 การสื่อสารแบบอนุกรม,” [Online]. https://www.artronshop.co.th/article/57/esp32-เบื้องต้น-บทที่-7-การสื่อสารแบบ อนุกรม. (https://www.artronshop.co.th/article/57/esp32-เบื้องต้น-บทที่-7-การสื่อสารแบบอนุกรม) [Accessed Seb. 17, 2022].
[14] Blynk. “Blynk,” [Online]. https://blynk.io/ . [Accessed Seb. 17, 2022].
[15] Ermi Media's, Syufrijal and Muhammad Rif'an. “Internet of Things (IoT): BLYNK Framework for Smart Home,” [Online]. https://knepublishing.com/index.php/Kne-Social/article/view/4128/8495#info. [Accessed Seb. 17, 2022].
[16] Apiset. “Ultrasonic Sensor Module (HC-SR04) 5V,” [Online]. https://www.arduitronics.com/product/20/ultrasonic-sensor-module-hc-sr04-5v . [Accessed Feb. 14, 2021].
[17] Apiset. “Ultrasonic Sensor Module (HC-SR04) 5V,” [Online]. https://www.arduitronics.com/product/20/ultrasonic-sensor-module-hc-sr04-5v . [Accessed Feb. 14, 2021].
[18] LungMaker. “การใช้งานบอร์ด Arduino MEGA 2560 เบื้องต้น,” [Online]. http://www.lungmaker.com/arduino-mega-2560-การใช้งาน/.
[Accessed Feb. 15, 2021].
[19] LungMaker. “การใช้งานบอร์ด Arduino MEGA 2560 เบื้องต้น,” [Online]. http://www.lungmaker.com/arduino-mega-2560-การใช้งาน/.
[Accessed Feb. 15, 2021].
[20] Analog Read. “Step Down/ โมดูลลดแรงดัน,” [Online]. https://www.analogread.com/product/254/dc-to-dc-step-down-lm2596-module-3a-โมดูลลดแรงดันไฟฟ้า-จ่ายกระแสได้สูงสุด-3a-สต็อกไทยส่งไว. (https://www.analogread.com/product/254/dc-to-dc-step-down-lm2596-module-3a-โมดูลลดแรงดันไฟฟ้า-จ่ายกระแสได้สูงสุด-3a-สต็อกไทยส่งไว) [Accessed Seb. 24, 2022].

[21] Analog Read. “Step Down/ โมดูลลดแรงดัน,” [Online]. https://www.analogread.com/product/254/dc-to-dc-step-down-lm2596-module-3a-โมดูลลดแรงดันไฟฟ้า-จ่ายกระแสได้สูงสุด-3a-สต็อกไทยส่งไว. (https://www.analogread.com/product/254/dc-to-dc-step-down-lm2596-module-3a-โมดูลลดแรงดันไฟฟ้า-จ่ายกระแสได้สูงสุด-3a-สต็อกไทยส่งไว) [Accessed Seb. 24, 2022].
[22] Myarduino. “บทความ Arduino เบื้องต้นแบบละเอียด,” [Online]. https://www.myarduino.net/article. [Accessed Jan. 9, 2021].
[23] Shapr3D. “Shapr3D,” [Online]. https://www.shapr3d.com/. [Accessed Seb. 17, 2022].

ประวัติผู้เขียน

การศึกษา
คุณวุฒิ | สถาบัน | ปีที่ส าเร็จการศึกษา
มัธยมศึกษาตอนต้น | โรงเรียนวรนารีเฉลิม สงขลา | 2556
มัธยมศึกษาตอนปลาย | โรงเรียนวรนารีเฉลิม สงขลา | 2559

กิจกรรม
- 2562 ผู้จัดกิจกรมมค่ายยุวชนคอมพิวเตอร์ ComCamp 29 ภาควิชาวิศวกรรมคอมพิวเตอร์ คณะวิศวกรรมศาสตร์ มหาวิทยาลัยสงขลานครินทร์
- 2565 เข้าร่วมอบรมโครงการ Blazor Programming และ Dev Guidelines
- 2565 เข้าร่วมอบรมโครงการ UX/UI Design with Figma
ชื่อ | นายปวเรศ ปิ่นแก้ว
รหัสนักศึกษา | 6010110680
