DreamPawaret/GPS-Mobile-Robot-Project/project/รายงานความก้าวหน้า/final/รายงานความก้าวหน้า_Project2_final.pdf

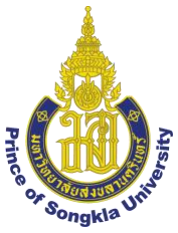
[picture p34: figure]

รายงานความก้าวหน้า 242-402 โครงงานวิศวกรรมคอมพิวเตอร์ 2 ครั้งที่ 2/2565 หุ่นยนต์เคลื่อนที่ควบคุมด้วยระบบ GPS GPS Mobile Robot

นายปวเรศ ปิ่นแก้ว
รหัสนักศึกษา 6010110680

อาจารย์ที่ปรึกษาโครงงาน
(ผศ.ดร.ธเนศ เคารพาพงศ์)

รายงานความก้าวหน้าโครงงานวิศวกรรมคอมพิวเตอร์นี้เป็นส่วนหนึ่งของการศึกษา ตามหลักสูตรปริญญาวิศวกรรมศาสตร์บัณฑิต สาขาวิชาวิศวกรรมคอมพิวเตอร์ คณะวิศวกรรมศาสตร์ มหาวิทยาลัยสงขลานครินทร์

### 5 ตุลาคม 2565

ก

ชื่อโครงงาน | หุ่นยนต์เคลื่อนที่ควบคุมด้วยระบบ GPS
ผู้จัดท า | นายปวเรศ ปิ่นแก้ว | รหัสนักศึกษา | 6010110680
สาขาวิชา | วิศวกรรมคอมพิวเตอร์
ปีการศึกษา | 2565
อาจารย์ที่ปรึกษาโครงงาน | คณะกรรมการสอบ
(ผศ.ดร.ธเนศ เคารพาพงศ์) | (ดร.สมชัย หลิมศิโรรัตน์)
| | | (ดร.อนันต์ ชกสุริวงค์)
(ผศ.ดร.นิคม สุวรรณวร)
(ผศ.ดร.ธเนศ เคารพาพงศ์)

โครงงานนี้เป็นส่วนหนึ่งของรายวิชาโครงงานวิศวกรรมคอมพิวเตอร์ 1 และ 2 ตามหลักสูตร ปริญญาวิศวกรรมศาสตร์บัณฑิต สาขาวิชาวิศวกรรมคอมพิวเตอร์ มหาวิทยาลัยสงขลานครินทร์

(รศ.ดร.พิชญา ตัณฑัยย์)
รักษาการแทนหัวหน้าสาขาวิชา วิศวกรรมคอมพิวเตอร์

ข

หนังสือรับรองความเป็นเอกลักษณ์ ข้าพเจ้าผู้ลงนามท้ายนี้ ขอรับรองว่ารายงานฉบับนี้เป็นรายงานที่มีความเป็นเอกลักษณ์ โดยที่ ข้าพเจ้ามิได้มีการคัดลอกมาจากที่ใด เนื้อหาในรายงานทั้งหมดถูกรวบรวมจากการพัฒนาในขั้นตอน ต่าง ๆ ของการจัดท าโครงงาน หากส่วนใดที่จ าเป็นต้องน าข้อความจากผลงานของบุคคลอื่นใดที่ไม่ใช่ ตัวข้าพเจ้า ข้าพเจ้าได้ท าการอ้างอิงถึงเอกสารเหล่านั้นไว้อย่างเหมาะสม และขอรับรองว่ารายงาน ฉบับนี้ไม่เคยเสนอต่อสถาบันใดมาก่อน

ผู้จัดท า

(นายปวเรศ ปิ่นแก้ว)

ค

ชื่อโครงงาน | หุ่นยนต์เคลื่อนที่ควบคุมด้วยระบบ GPS
ผู้จัดท า | นายปวเรศ ปิ่นแก้ว | รหัสนักศึกษา | 6010110680
สาขาวิชา | วิศวกรรมคอมพิวเตอร์
ปีการศึกษา | 2565

บทคัดย่อ
เนื้อความบทคัดย่อ
โครงงานหุ่นยนต์เคลื่อนที่ควบคุมด้วยระบบ GPS เป็นโครงงานที่พัฒนาขึ้นเพื่อน าระบบระบุ ต าแหน่งบนโลก(GPS) มาประยุกต์ใช้กับหุ่นยนต์ โดยใช้การระบุพิกัดของ GPS มาใช้ในการก าหนด พิกัดที่ต้องการให้หุ่นยนต์เคลื่อนที่ไป เพื่อน าไปประยุกต์ในการใช้งานต่างๆภายนอกอาคาร เช่น การ ส่งพัสดุหรือการส ารวจพื้นที่ โดยจะใช้หุ่นยนต์เคลื่อนที่อย่างง่าย ที่มีบอร์ด Arduino เป็นตัวหลักใน การควบคุม และสั่งการเซ็นเซอร์ต่างๆของหุ่นยนต์

ค าส าคัญ ระบบระบุต าแหน่งบนโลก(GPS) มุมทิศ Haversine formular Azimuth formular

ง

Project | GPS Mobile Robot
Author | Mr.Pawaret Pinkaew Student ID | 6010110680
Major Program | Computer Engineering
Academic Year | 2022

Abstract
Description
GPS Mobile Robot is a project developed to apply global positioning system (GPS) to robots, using GPS coordinates to determine the target location that you want the robot to move. To be used in various applications outside the building such as parcel delivery or surveying the area, using a simple mobile robot that has an Arduino board as the main control. and command various sensors of the robot

Keyword Global Positioning System (GPS) Azimuth angle Haversine formular
Azimuth formular

จ

กิตติกรรมประกาศ
โครงงานนี้ส าเร็จลุล่วงได้ด้วยความกรุณาจาก ผศ.ดร.ธเนศ เคารพาพงศ์ อาจารย์ที่ปรึกษา โครงงานที่ได้ให้ค าเสนอแนะ แนวคิด ตลอดจนการแก้ไขข้อบกพร่องต่าง ๆ มาโดยตลอดจนโครงงาน เล่มนี้เสร็จสมบูรณ์ ผู้จัดท าจึงขอกราบขอบพระคุณเป็นอย่างสูง
ขอบพระคุณ ผศ.ดร.นิคม สุวรรณวร ดร.อนันท์ ชกสุริวงค์ และ ดร.สมชัย หลิมศิโรรัตน์ ที่ให้ ค าแนะน าและข้อคิดต่ าง ๆ ในการจัดท าโครงงานฉบับนี้
ขอบพระคุณ คุณอนันต์ นิลโกสีย์ ที่ให้ค าแนะน าในการใช้งานเครื่องมือช่าง การเลือกวัสดุ และอุปกรณ์ที่ใช้งานในโครงงานและออ านวยความสะดวกในการใช้งานเครื่องมือ ขอบพระคุณคุณวิมล ค าจันทร์ ที่อ านวยความสะดวกในการลงทะเบียนเรียนรายวิชา โครงงาน
ขอบพระคุณผู้ปกครอง ที่ให้การสนับสนุน และขอขอบคุณพี่ๆรวมทั้งเพื่อน ๆ ที่ให้ความ ช่วยเหลือและให้ค าปรึกษาแนวท างในก ารท าโครงงานนี้

ปวเรศ ปิ่นแก้ว

ฉ

สารบัญ
หนังสือรับรองความเป็นเอกลักษณ์ | ข
บทคัดย่อ | ค
Abstract | ง
กิตติกรรมประกาศ | จ
สารบัญ | ฉ
สารบัญรูปภาพ | ฌ
สารบัญตาราง | ญ

ช

ซ

ฌ

สารบัญรูปภาพ

ญ

สารบัญตาราง

บทที่1
บทน า
ที่มาและความส าคัญ
ปัจจุบันหุ่นยนต์เริ่มเข้ามามีบทบาทในกิจกรรมต่างๆของมนุษย์มากขึ้น จึงมีการพัฒนาอย่าง รวดเร็วและ กว้างขวาง เพื่อช่วยแบ่งเบาภาระการท างานหรือเพิ่มประสิทธิภาพในการท างาน เช่น หุ่นยนต์บริการในร้านอาหาร BellaBot [1] ท าหน้าที่ให้บริการต้อนรับลูกค้า รับออร์เดอร์ และเสิร์ฟ อาหาร ซึ่งหุ่นยนต์ตัวนี้มีการใช้ AI ในการควบคุมเซ็นเซอร์หลายๆตัวเช่น การตรวจสอบการเคลื่อนไหว การระบุต าแหน่งภายในร้าน หากกล่าวถึงการระบุต าแหน่งแล้ว เทคโนโลยีที่มีความสามารถในการ ระบุต าแหน่งได้อย่างแม่นย าในปัจจุบันก็คือระบบ Global Positioning System (GPS) ซึ่งสามารถ น ามาประยุกต์ใช้เพื่อให้เกิดประโยชน์มากมายไม่ว่าจะ เป็น การท าแผนที่ ระบบน าร่อง หรือการ ติดตามยานพาหนะ อีกทั้งยังเป็นระบบที่ทุกคนสามารถเข้าถึงและใช้งาน ได้ง่าย ผู้จัดท าจึงมีความ สนใจที่จะน าระบบ GPS มาประยุกต์ใช้กับหุ่นยนต์ โดยใช้การระบุพิกัดของระบบ GPS มา ใช้ในการ ควบคุมทิศทางการเคลื่อนที่ของหุ่นยนต์เพื่อน าไปประยุกต์ในการใช้งานต่างๆภายนอกอาคาร เช่น การ ส่งพัสดุหรือการส ารวจพื้นที่ โดยจะใช้หุ่นยนต์เคลื่อนที่อย่างง่าย ที่มีบอร์ด Arduino เป็นตัวหลักใน การควบคุม และสั่งการเซ็นเซอร์ต่างๆของหุ่นยนต์

วัตถุประสงค์ของโครงงาน
1. เพื่อสร้างหุ่นยนต์ที่สามารถเคลื่อนที่ได้อัตโนมัติโดยใช้การระบุพิกัดด้วย GPS เป็นตัวควบคุม
2. เพื่อสร้างโปรแกรมในการก าหนดต าแหน่งเพื่อให้หุ่นยนต์เคลื่อนที่

ประโยชน์ที่คาดว่าจะได้รับ
1. สามารถสร้างหุ่นยนต์ที่สามารถเคลื่อนที่ได้อัตโนมัติตามต าแหน่งที่ระบุด้วยพิกัดจาก GPS ได้
2. สามารถสร้างโปรแกรมส าหรับการระบุต าแหน่งที่ต้องการให้หุ่นยนต์เคลื่อนที่ไปได้
3. สามารถน าการระบุพิกัด GPS ไปใช้ในการควบคุมทิศทางการเคลื่อนที่ของหุ่นยนต์ได้

ขอบเขตของโครงงาน
1. หุ่นยนต์สามารถเคลื่อนที่ได้ตามต าแหน่งที่ระบุบน GPS
2. หุ่นยนต์สามารถหลบสิ่งกีดขวางขนาดเล็กที่หยุดนิ่งได้
3. สามารถค านวณระยะทางและความเร็วในการเคลื่อนที่ศึกของหุ่นได้

2

แผนการด าเนินงาน
ขั้นตอนการด าเนินการ | Project Preparation (2/63) | Project I (1/64) | Project II (1/65)
ธ.ค. | ม.ค. | ก.พ. | มี.ค. | เม.ย. | มิ.ย. | ก.ค. | ส.ค. | ก.ย. | ต.ค. | มิ.ย. | ก.ค. | ส.ค. | ก.ย. | ต.ค.
1.ศึกษาหัวข้อโครงงาน
2.ศึกษางานวิจัยและเอกสารที่เกี่ยวข้องกับโครงงาน 3.ศึกษาระบบ GPS และระบบควบคุมที่ใช้ GPS 4.ศึกษาการท างานของอุปกรณ์และเซ็นเซอร์ต่างๆ ที่ใช้ในโครงงาน

5.ศึกษาการเขียนโปรแกรมส าหรับควบคุม microcontroller

6.ออกแบบหุ่นยนต์และระบบการท างาน 7.ออกแบบโปรแกรมและเขียนโปรแกรมส าหรับการท างาน ของ Microcontroller

8.พัฒนาหุ่นยนต์และเขียนโปรแกรมส าหรับควบคุม Microcontroller

9.ทดลองและวัดผลการทดลอง
10.สรุปผลการทดลอง
11.จัดท าเล่มโครงงาน
ตารางที่1 แผนการด าเนินงาน

บทที่2
ทฤษฎีและหลักการ
GPS
GPS ย่อมาจาก Global Positioning System หรือระบบระบุต าแหน่งบนพื้นโลก โดยอาศัย ดาวเทียม ซึ่งโคจรอยู่รอบโลก ดาวเทียมดวงหนึ่งโคจรรอบโลก 1 รอบ ใช้เวลา 12 ขั่วโมง ระบบ GPS ท างานโดยการรับสัญญาณจากดาวเทียม ซึ่งประกอบไปด้วยประกอบไปด้วยข้อมูลที่ระบุต าแหน่งและ เวลาขณะส่งสัญญาณ เครื่องรับสัญญาณดาวเทียมจะค านวนระยะทางระหว่างดาวเทียมและเครื่องรับ สัญญาณ เพื่อความแม่นย าในการค านวณต าแหน่ง ต้องใช้ดาวเทียมอย่างน้อย 4 ดวง นอกจากนี้ความ แม่นย าของการระบุต าแหน่งนั้นขึ้นอยู่กับต าแหน่งของดาวเทียมแต่ละดวง ความแปรปรวนของชั้น บรรยากาศ และสิ่งแวดล้อมในบริเวณรับสัญญาณ [2][3]
ส่วนการควบคุมการน าทาง

### 2.2.1 Navigation vector

เพื่อให้หุ่นยนต์สามารถเคลื่อนที่ไปยังพิกัดที่ก าหนดได้ จะใช้ระยะทาง และมุมที่ต้องเคลื่อนที่ใน การน าทาง และเพื่อให้รู้ค่าดังกล่าว จะใช้ค่าพารามิเตอร์ 3 ตัวคือ พิกัดเป้าหมาย พิกัดของหุ ่นยนต์ และทิศทางของหัวหุ่นยนต์ที่สัมพันธ์กับเหนือ(robot_car_heading) ซึ่งได้จากโมดูลเข็มทิศและโมดูล GPS

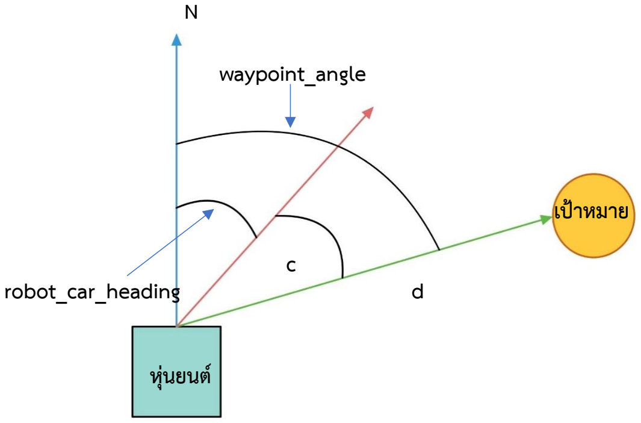
[picture p35: figure]
robot_car_heading; waypoint_angle; เป้าหมาย; หุ่นยนต์

รูปที่ 1 การค านวณทิศทางและมุมส าหรับการน าทาง

ในค านวณระยะทางระหว่างพิกัดที่หุ่นอยู่ ณ ปัจจุบันกับพิกัดจุดหมาย ใช้พิกัดละติจูด ลองจิจูด ของต าแหน ่ง 2 ต าแหน ่งในการค านวณ ใช้Haversine formular เป็นสมการในการค้นหา จาก สมการ

∆φ = φ2 − φ1

∆λ = λ2 − λ1

a = sin² (

∆φ
2

) + cos(φ1) ∙ cos(φ2) ∙ sin² (

∆λ
2

)

d = R ∙ 2 ∙ arctan2(√a, √1 − a)
เมื่อ ∅1 คือละติจูดของหุ่นยนต์ ∅2 คือละติจูดของเป้าหมาย
λ1 คือลองจิจูดของหุ่นยนต์
λ2 คือลองจิจูดของเป้าหมาย
R คือรัศมีของโลก (6317 km.) d คือระยะทางระหว่าง GPS 2 จุด ส าหรับการหามุมที่รถต้องหมุนไป(มุม c) เพื่อให้หันไปตรงกับพิกัดเป้าหมายหาได้จากสมการ c = waypoint_angle – robot_car_heading
robot_car_heading เป็นมุมตามเข็มนาฬิกาที่หุ่นยนต์ท ากับทิศเหนือหาได้จากการใช้โมดูลเข็มทิศ waypoint_angle เป็นมุมตามเข็มนาฬิกาที่เป้าท ากับทิศเหนือหาได้จาก Azimuth formular จาก สมการ

c = arctan2(sin(Δλ)cos(φ2

), cos(φ1

)sin(φ2

) − sin (φ1)cos (φ2)cos (Δλ))
ค่าที่ได้จากสมการมีทั้งบวกและลบขึ้นอยู่กับทิศของเป้าหมาย หากอยู่ฝั่งทิศเหนือจะมีค่าเป็น บวก หากอยู่ฝั่งทิศใต้จะมีค่าเป็นลบ จึงต้องน ามาบวกด้วย 360 เพื่อให้ได้มุมตามเข็มนาฬิกาที่เป้าท า กับทิศเหนือ

### 2.2.2 Navigation control

ในการควบคุมส าหรับการน าทางนั้น ก่อนอื่นต้องลดความคาดเคลื่อนของทิศทางการมุ่งหน้าไป ยังพิกัดเป้าหมาย(มุม c) โดยหันหุ ่นยนต์ไปทางขวาหากค ่าความคาดเคลื ่อนเป็นบวก และหันไป ทางซ้ายหากค่าความคาดเคลื่อนเป็นลบ ผู้จัดท าโครงงานได้ก าหนดช่วงของความคาดเคลื่อนไว้ที่ ±10 องศา
เนื่องจากเป็นเรื่องยากที่จะลดค่าความคาดเคลื่อนให้เหลือศูนย์ ในขณะเดียวกันก็ต้องลดความ คาดเคลื่อนของระยะทางโดยการให้หุ่นยนต์เคลื่อนที่ไปข้างหน้าในทิศทางที่ใกล้เคียงกับพิกัดเป้าหมาย แต่การเคลื่อนที่ไปข้างหน้านั้นจะท าให้ค่าความคาดเคลื่อนของทิศทางการเคลื่อนที่ทีค่าเพิ่มขึ้นทั้งใน ทางบวกและทางลบ จึงต้องมีการท าซ ้าไปเรื่อยๆในการค านวณ navigation vector และการควบคุม การน าทางเพื่อลดค่าความคาดเคลื่อนทั้งสองให้เหลือน้อยที่สุดจนกว่าหุ่นยนต์จะเคลื่อนที่ไปยังพิกัด เป้าหมายได้โดยเมื่อหุ่นยนต์เคลื่อนที่ไปอยู่ในรัศมีประมาณ 1-3 เมตรของพิกัดเป้าหมายจะถือว่า สามารถเคลื่อนที่ไปยังพิกัดเป้าหมายได้ส าเร็จ
ส าหรับเส้นทางในการเคลื่อนที่ของหุ่นยนต์นั้น จะเป็นเส้นทางตรงไปยังพิกัดเป้าหมาย คือใช้ ต าแหน่ง ณ ปัจจุบันของตัวหุ่นยนต์เป็นจุดอ้างอิงในการหาเส้นทางในการเคลื่อนที่ ดังนั้นเมื่อหุ่นยนต์ มีการเลี้ยวหรือเคลื่อนที่ออกนอกทิศทางของการเคลื่อนที่ เส้นทางการเคลื่อนที่จะเปลี่ยนไปเสมอ แต่ ทุหเส้นทางจะเป็นระยะกระจัดจากหุ่นยนต์ถึงพิกัดเป้าหมาย
อุปกรณ์

### 2.3.1 เครื่องรับสัญญาณ GPS GY-NEO6MV2

โมดูล GPS GY-NEO6MV2 เป็นโมดูล U-blox รุ่น NEO-6M สามารถเชื่อมต่อได้กับ ไมโครคอนโทรเลอร์หลายหลายประเภทไม่ว่าจะเป็น Arduino, NodeMCU, Raspberry Pi, ESP32 ผ่านทาง Serial UART ความเร็วที่ 9600 (สามารถอัพได้) และต าแหน่งอัพเดทตลอดทุกๆ 1 วินาที สามารถตั้งค่าให้เร็วกว่านี้ได้ การท างานเมื่อตัวโมดูลจับสัญญาณได้จะขึ้นไฟสีเขียวกระพริบ ตัวโมดูลมี แบตเตอรี่เก็บต าแหน่งล่าสุดและคอนฟิกต่างๆ โดยจะมีความแม่นย าของพิกัดอยู่ที่ 2.5 CEP หรือก็คือ ภายในรัศมี 2.5 เมตร [4]

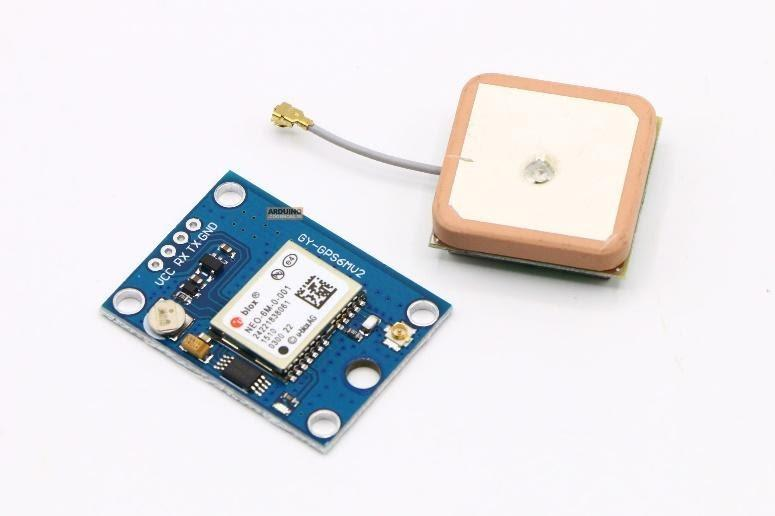
[picture p36: figure]

รูปที่ 2 เครื่องรับสัญญาณ GPS GY-NEO6MV2 และเสาอากาศ ที่มา http://www.iot.codemobiles.com/product/296/gy-neo6mv2-gps-module-neo6mv2-with-gps-antenna

### 2.3.1 Ultrasonic Sensor HC-SR04


รูปที่ 3 Ultrasonic Sensor HC-SR04 ที่มา https://www.arduitronics.com/product/20/ultrasonic-sensor-module-hc-sr04-5v

เป็นโมดูลที่ใช้หาระยะห่างระหว่างวัตถุกับเซ็นเซอร์ โดยส่งสัญญาณอัลตร้าโซนิค ความถี่
40 kHz ไปที่วัตถุที่ต้องการวัดและรับสัญญาณที่สะท้อนกลับมาพร้อมทั้งจับเวลาเพื่อน ามาใช้ในการ ค านวณระยะทาง [5]

### 2.3.1 Shinano Kenshi DCG-5216-038


รูปที่ 4 Shinano Kenshi DCG-5216-038

เป็นมอเตอร์กระแสตรง รองรับแรงดันสูงสุดที่ 24 โวลต์ รองรับกระแสที่ 0.34 แอมป์ สูงสุดที่ 4 แอมป์โดยที่ไม่มีโหลด ความเร็วรอบอยู่ที่ 670 rpm และก าลัง 50 วัตต์

### 2.3.1 GY-273 3-axis Compass Module (HMC5883L)


รูปที่ 5 GY-273 3-axis Compass Module (HMC5883L) ที่มา https://www.analogread.com/product/446/gy-273-3-axis-compass-module-hmc5883l

เป็นโมดูลเข็มทิศ ใช้ชิป HMC5883L วัดสนามแม่เหล็ก 3 แกน สามารถประยุกต์ใช้งานเป็น เช็มทิศได้[6] มีความแม่นย าของเข็มทิศที่ 1-2 องศา [7]

### 2.3.2 BTS7960 H-Bridge DC Motor Drive (6-27V 47A Max) Module


รูปที่ 6 Motor Drive Module BTS7960 ที่มา https://www.arduino4.com/product/844/btn7960-bts7960-43a-current-limiting-high-power-h-bridge-dc-motor-drive-module-โมดูขับ-motor-dc\

ใช้ส าหรับขับดีซีมอเตอร์ที ่ต้องการกระแสสูงๆ ใช้สัญญาณ PWM ในการควบคุมความเร็ว รองรับความเร็ว ของ PWM ได้ถึง 25 KHz สามารถควบคุมมอเตอร์ได้ 1 ตัว และควบคุมหมุนซ้าย ขวา (กลับทาง)ได้ แรงดันไฟเลี้ยงมอเตอร์ : 6-27Vdc กระแสเอาต์พุตสูงสูง: 47A Max (ก าหนด จากสเปคของ BTS7960) ในทางปฏิบัติควรใช้กระแสไม่เกิน 20A เพื่อความปลอดภัย [8]

### 2.3.3 Arduino Mega 2560

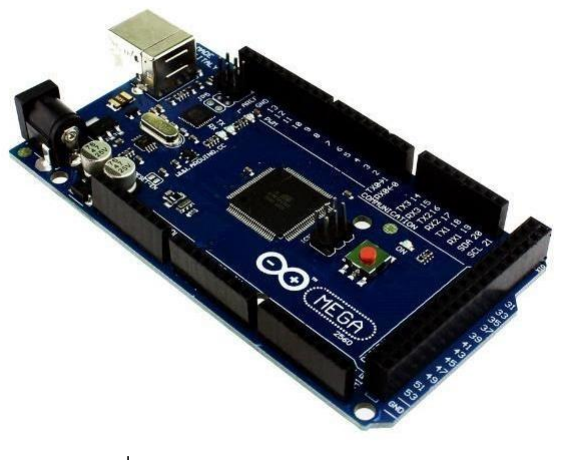
[picture p37: figure]

รูปที่ 7 Arduino Mega 2560 ที่มา http://www.lungmaker.com/arduino-mega-2560-การใช้งาน/

Arduino MEGA คือบอร์ดร ุ ่นใหญ ่ในกล ุ ่มบอร์ด Arduino โดยใช้ Atmega2560 เป็น ไมโครคอนโทรลเลอร์หลัก โดย Arduino MEGA มี Digital Pins ขา input/output digital จ านวน 54 ขา (เป็น PWM ได้ 15 ขา) มี Analog Input 16 ขา Serial UART 4 ชุด I2C 1 ชุด SPI 1 ชุด และ ขาแหล่งจ่ายไฟ 5V จ านวน 3 ขา สามารถเขียนโปรแกรมบน Arduino IDE และโปรแกรมผ่าน
USB [9]

### 2.3.4 NodeMCU ESP8266

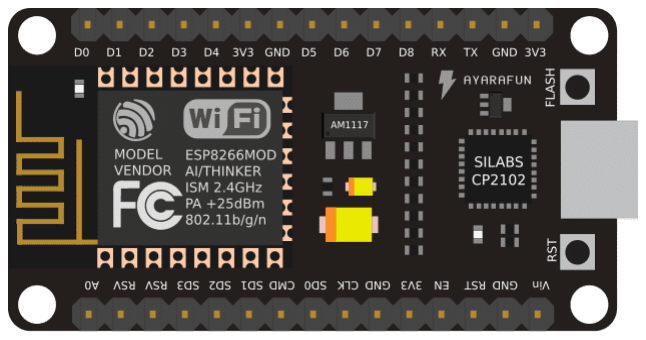
[picture p38: figure]

รูปที่ 8 NodeMCU ESP8266
ที่มา https://www.allnewstep.com/article/30/nodemcu-esp8266-esp8285-arduino-1-esp8266-คือ

เป็นชื ่อเรียกของชิฟของโมดูล ESP8266 ส าหรับติดต ่อสื ่อสารบนมาตรฐาน WiFi ท างานที่ แรงดันไฟฟ้า 3.0-3.6V ท างานใช้กระแสโดยเฉลี่ย 80mA ภายในมี Low power MCU 32bit ท าให้ เราเขียนโปรแกรมสั่งงานโดยใช้ Arduino IDE ได้ มีวงจร analog digital converter ท าให้สามารถ อ่านค่าจาก analog ได้ความละเอียด 10bit [10]

### 2.3.5 Step down


รูปที่ 9 Step down
ที่มา https://www.analogread.com/category/101/ระบบไฟเลี้ยง /step-down-โมดูลลดแรงดัน

DC-to-DC Step Down LM2596 Module เป็นโมดูลแปลงไฟ DC Step Down (แปลงไฟ ลง) สามารถปรับค่าได้ตั้งแต่ 1.25-35V โดยปรับค่าที่ Potentiometer โมดูลสามารถจ่ากระแสได้ สูงสุด 3A [11]

เทคโนโลยีที่ใช้

### 2.4.1 Arduino IDE

Arduino IDE หรือชื่อเต็มคือ Arduino Integrated Development Environment เป็นชุด เครื่องมือส าหรับการเขียนโปรแกรมควบคุม Microcontroller เช่น Text editor ส าหรับการเขียน Code ตัว Compiler และอัปโหลดโปรแกรมลงบอร์ด Arduino [12]
แนวคิดการใช้งานโปรแกรม Arduino IDE
1. เขียนโปรแกรมด้วยภาษา C/C++
2. คอมไพล์โปรแกรมภาษา C/C++ เป็นภาษาส าหรับ Microcontroller และบันทึกเป็น Hex file
3. อัปโหลด Intel Hex File ลงบน Microcontroller ผ่านสาย USB

### 2.4.2 Blynk

รูปที่ 10 Blynk Application ที่มา https://blynk.io/

Blynk เป็นแพลตฟอร์มแอฟพลิเคชั่นที่ช่วยให้สามารถสร้างอินเตอร์เฟซส าหรับควบคุมและ ตรวจสอบฮาร์ดแวร์โปรเจคได้จากอุปกรณ์ทั้ง IOS และ Android ได้อย ่างรวดเร็ว [13] โดยผู้ใช้ สามารถลากและวางเครื ่องมือ (widgets) ที ่มีให้เลือกใช้อย ่างมากมาย Blynk นั้นถูกออกแบบมา ส าหรับ Internet Of Things ท าให้สามารถควบคุมฮาร์ดแวร์ได้จากระยะไกล สามารถแสดงข้อมูล เซ็นเซอร์ จัดเก็บข้อมูล แสดงภาพ และท าสิ่งอื่นๆ ได้มากมาย รองรับอุปกรณ์ฮาร์ดแวร์ที่หลากหลาย ไม่ว่าจะเป็น Arduino NodeMCU หรือ Raspberry pi สามารถใช้งานได้ฟรี แต่จะจ ากัดเครื่องมือ หากต้องการใช้เครื่องมือนอกเหนือจากที่ให้บริการฟรี จะมีค่าใช้จ่ายเพิ่มเติม

### 2.4.3 Shapr3D

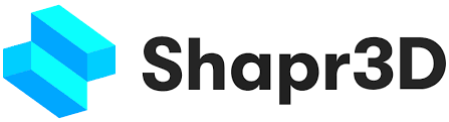
[picture p39: figure]

รูปที่ 11 Shapr3D
ที่มา https://www.shapr3d.com/Shapr3D เป็นเครื่องมือการสร้างแบบจ าลอง 3 มิติส าหรับการออกแบบทางกลไก สามารถใช้ งานได้ทั้ง IOS Android และ Windows บนอุปกรณ์ที่รองรับ

บทที่3
รายละเอียดการด าเนินงาน
ภาพรวมของโครงงาน
โครงสร้างของโครงงานนี้ประกอบด้วย 2 ส่วน คือ ส่วนที่ 1 ส่วนของฮาร์ดแวร์ ประกอบด้วย โครงสร้างของตัวหุ่นยนต์ Microcontroller การติดตั้งอุปกรณ์ควบคุมและเซ็นเซอร์ได้แก่ เครื่องรับ สัญญาณ GPS, NodeMCU ESP8266, Ultrasonic Sensor และ Compass module ส่วนที่ 2 ส่วน ของซอฟต์แวร์ ประกอบด้วย แอปพลิเคชันส าหรับก าหนดพิกัดให้กับหุ่นยนต์โปรแกรมที่เขียนลงบน บอร์ด Arduino ส าหรับควบคุมการท างานของหุ่นยนต์ ได้แก่ การรับค่าจากเซ็นเซอร์ การค านวณ ทิศทางหรือองศาการเคลื่อนที่ของหุ่นยนต์ การควบคุมการหมุนของล้อ การป้อนพิกัด GPS ให้แก่ หุ่นยนต์ และการรับส่งข้อมูลจากหุ่นยนต์


รูปที่ 12 ภาพรวมของโครงงาน

รายละเอียดของฮาร์ดแวร์
Block Diagram โครงสร้างของหุ่นยนต์

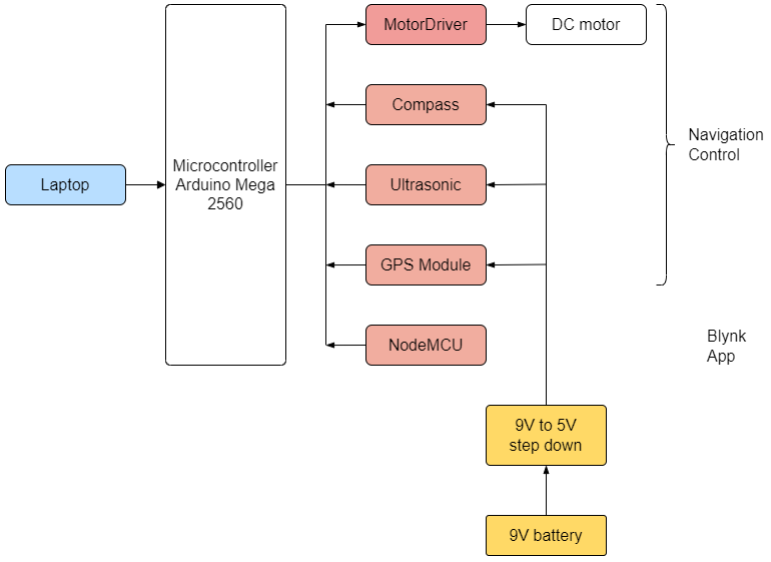
[picture p40: figure]

รูปที่ 13 ส่วนประกอบและการเชื่อมต่อของหุ่น

การท างานของระบบ


รูปที่ 14 การท างานของระบบ

ออกแบบหุ่นยนต์
ออกแบบหุ่นยนต์เคลื่อนที่ใหม่ให้มีขนาดที่ใหญ่ขึ้นเพื่อให้มีความเหมาะสมส าหรับการใช้งาน ภายนอกอาคาร โดยตัวหุ่นจะมีขนาด 35 x 50 เซนติเมตร ใช้ล้อยางตันที่มีขนาดเส้นผ่านศูนย์กลาง 8 นิ้ว ใช้มอเตอร์ SHINANO KENSHI DCG-5216-038 ที ่มีสามารถขับแรงดันได้สูงสุด 24vในการ ขับเคลื่อนล้อ มีล้อหมุนอิสระข้างหน้า 1 ล้อเพื่อค ้าโครงสร้างของตัวหุ่น


รูปที่ 15 โครงสร้างของหุ่นยนต์ที่ออกแบบ

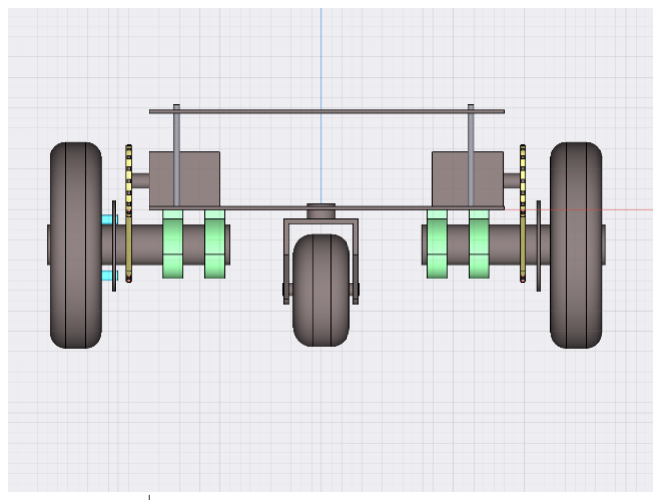
[picture p41: figure]

รูปที่ 16 มุมมองด้านหน้าของหุ่นยนต์


รูปที่ 17 มุมมองด้านข้างของหุ่นยนต์

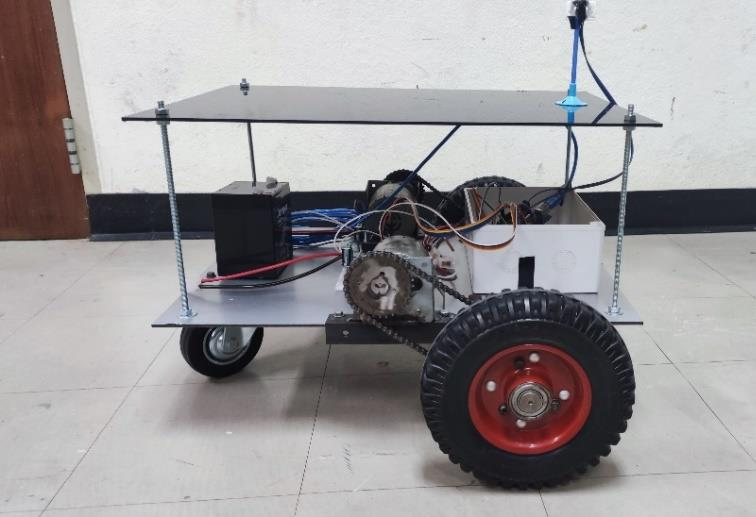
[picture p42: figure]

รูปที่ 18 หุ่นยนต์ที่สร้างเสร็จ

บทที่4
ความก้าวหน้าการด าเนินงาน
ความก้าวหน้า 1 พัฒนาอินเตอร์เฟซส าหรับการก าหนดพิกัดเป้าหมายให้หุ่นยนต์

### 4.1.1 รายละเอียดการพัฒนา

พัฒนาอินเตอร์เฟซส าหรับการก าหนดพิกัดเป้าหมายให้หุ่นยนต์ โดยใช้Blynk Application ในหน้าอินเตอร์ใช้ widgets ของ Blynk 2 อย่างประกอบด้วย text input 2 ช่องส าหรับป้อนพิกัด ละติจูดและลองจิจูด Value Display ส าหรับแสดงค่าพิกัดละติจูดและลองจิจูดที่ป้อนลงไป

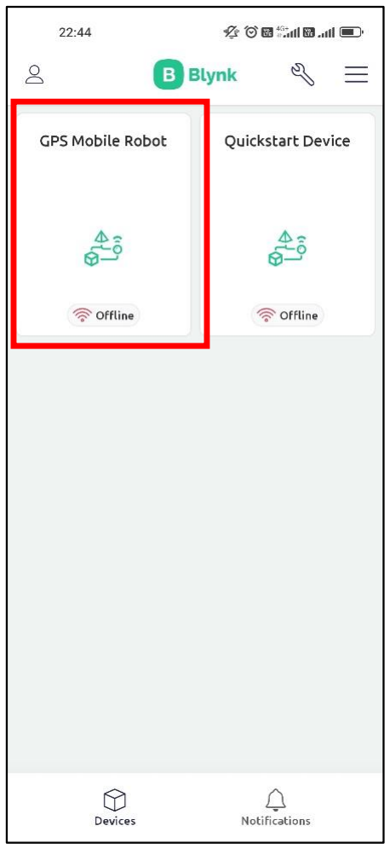
[picture p43: figure]
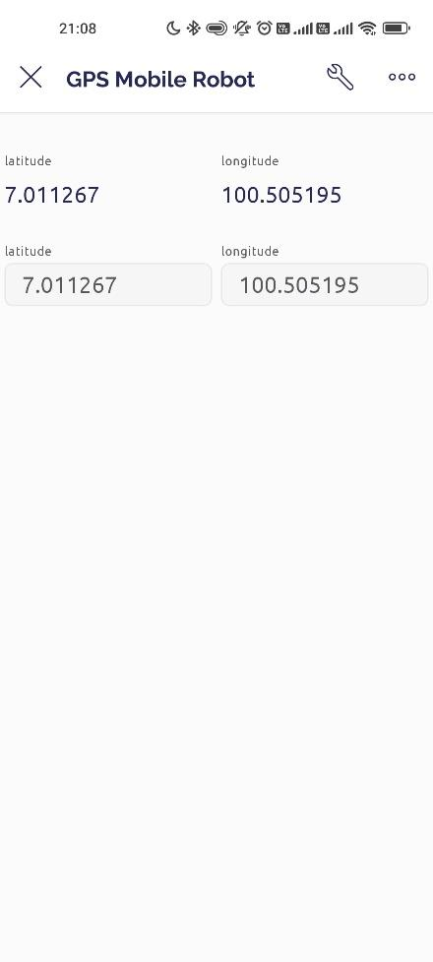
[picture p44: figure]

รูปที่ 19 หน้าอินเตอร์เฟซส าหรับการก าหนดพิกัด


รูปที่ 20 การเชื่อมต่ออุปกรณ์กับ Blynk

### 4.1.2 อุปสรรคในการพัฒนา

1. wifi ของมหาวิทยาลัยที่เป็บแบบ 802.1x ท าให้ค่อนข้างล าบากต่อการเชื่อมต่อgกับ เครือข่ายอินเตอร์เน็ต
2. datastrem ตัวแปรประเภท double ของ blynk มีข้อจ ากัดในการป้อนต าแหน่ง ทศนิยมได้เพียง 5 หลักเท่านั้น แต่พิกัดละติจูดและลองจิจูดที่ใช้ในโครงงานนนี้ใช้ ทศนิยม 5 ต าแหน่ง

### 4.1.3 แนวทางการแก้ปัญหา

1. เชื่อมต่อกับเครือข่ายอินเตอร์เน็ตโดยใช้ mobile hotspot
2. เปลี่ยนประเภทของตัวแปรที่ใช้ในการป้อนข้อมูลใน Blynk มาเป็น string จากนั้นแปลง เป็น float แล้วจึงส่งข้อมูลไปยัง Arduino

ความก้าวหน้า 2 การส่งข้อมูลระหว่าง Arduino และ Nodemcu

### 4.2.1 รายละเอียดการพัฒนา

เชื่อมต่อ Arduino mega 2560 พิน 14(TX) และ 15(RX) เข้ากับ Nodemcu ขาD2(RX) และ D1(TX) ตามล าดับ การรับส่งข้อมูลจะใช้การสื่อสารแบบอนุกรม(Serial) โดยที่ Nodemcu จะเป็นตัว ส่งข้อมูลพิกัดที่ป้อนผ่าน Blynk application มายัง Arduino

เนื่องจากข้อจ ากัดของตัวแปรประเภท float ที่ใช้ในการเก็บค่าพิกัดละติจูดและลองจิจูด ใน เรื่องของขนาดของข้อมูลและความแม่นย าของต าแหน่งทศนิยม ก่อนการส่งข้อมูลจึงคูณค่าพิกัดด้วย 1000000 เพื่อให้ต าแหน่งทศนิยมที่ใช้มาเป็นจ านวณเต็ม จากนั้นเมื่อ Arduino รับข้อมูลมา จะน า ข้อมูลนั้นมาหารด้วย 100000 เพื่อให้เหลือทศนิยมต าแหน่งที่ต้องการ

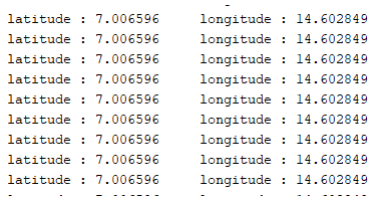
[picture p45: figure]

รูปที่ 21 ข้อมูลที่ยังไม่ได้คูณด้วย 1000000 ก่อนการส่ง


รูปที่ 22 ข้อมูลที่คูณด้วย 1000000 ก่อนการส่งแล้ว

ในการรับส่งข้อมูลนั้น เมื่อรับส่งข้อมูลไปได้ระยะเวลาหนึ่ง พิกัดละติจูดและลองติจูดที่ได้รับจะ สลับต าแหน่งกันและค่าพิกัดคาดเคลื่อนไปเยอะมาก จึงต้องใส่ prefix ก่อนการส่งข้อมูล เพื่อใช้ในการ ตรวจสอบว่า ข้อมูลที่ได้รับมานั้นเป็นพิกัดละติจูดหรือลองจิจูด

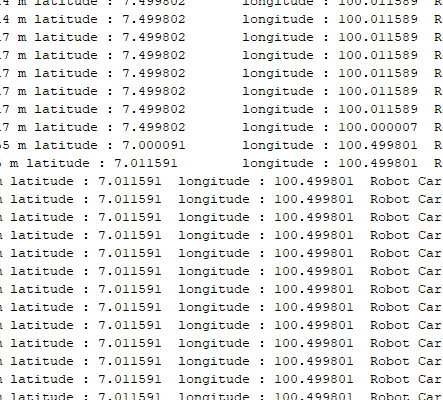
[picture p46: figure]

รูปที่ 23 การรับส่งค่าพิกัดก่อนใส่ prefix

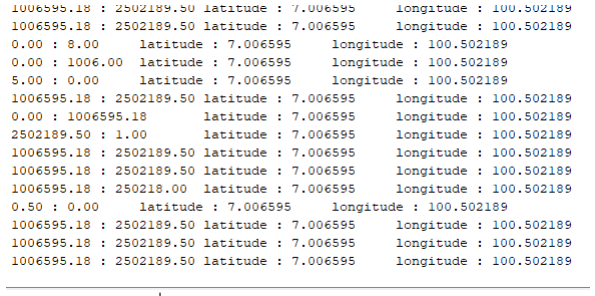
[picture p47: figure]

รูปที่ 24 การรับส่งพิกัดหลังการใส่ prefix

หลังจากใส่ prefix ในการส่งข้อมูลแล้ว เมื่อตรวจสอบแล้วว่าข้อมูลที่รับมาถูกต้อง จะอัพเดท ข้อมูลพิกัด หากข้อมูลที่รับมาไม่ถูกต้อง ก็จะไม่มีการเก็บข้อมูลในตัวแปรนั้น

### 4.2.2 อุปสรรคในการพัฒนา

1. ข้อจ ากัดของตัวแปรประเภท float ที่ใช้ในการเก็บค่าในเรื่องของขนาดข้อมูลและความ แม่นย าของต าแหน่งทศนิยม
2. พิกัดละติจูดและลองติจูดที่ได้รับจะสลับต าแหน่งกันและค่าพิกัดคาดเคลื่อน

### 4.2.3 แนวทางการแก้ปัญหา

1. ก ่อนการส ่งข้อมูลจึงคูณค ่าพิกัดด้วย 1000000 เพื ่อให้ต าแหน ่งทศนิยมที ่ใช้มาเป็น จ านวณเต็ม จากนั้นเมื ่อ Arduino รับข้อมูลมา จะน าข้อมูลนั้นมาหารด้วย 100000 เพื่อให้เหลือทศนิยมต าแหน่งที่ต้องการ
2. ใส่ prefix ก่อนการส่งข้อมูล เพื่อใช้ในการตรวจสอบว่า ข้อมูลที่ได้รับมานั้นเป็นพิกัด ละติจูดหรือลองจิจูด

ความก้าวหน้า 3 หาค่าความคาดเคลื่อนของพิกัด

### 4.3.1 รายละเอียดการพัฒนา

ทดสอบโดยการให้หุ่นยนต์เคลื่อนที่ไปยังพิกัดที่ก าหนด โดยใช้พิกัดเดิมทุกครั้งในการเคลื่อนที่ บันทึกระยะห่างระหว่างพิกัดเป้าหมายกับพิกัดที่หุ่นยนต์เคลื่อนที่ไปถึง หากอยู่ในระยะ 3 เมตรถือว่า ถึงพิกัดเป้าหมายแล้ว (ค่าความแม่นย าของ GPS อยู่ในระยะ 2.5 เมตร)

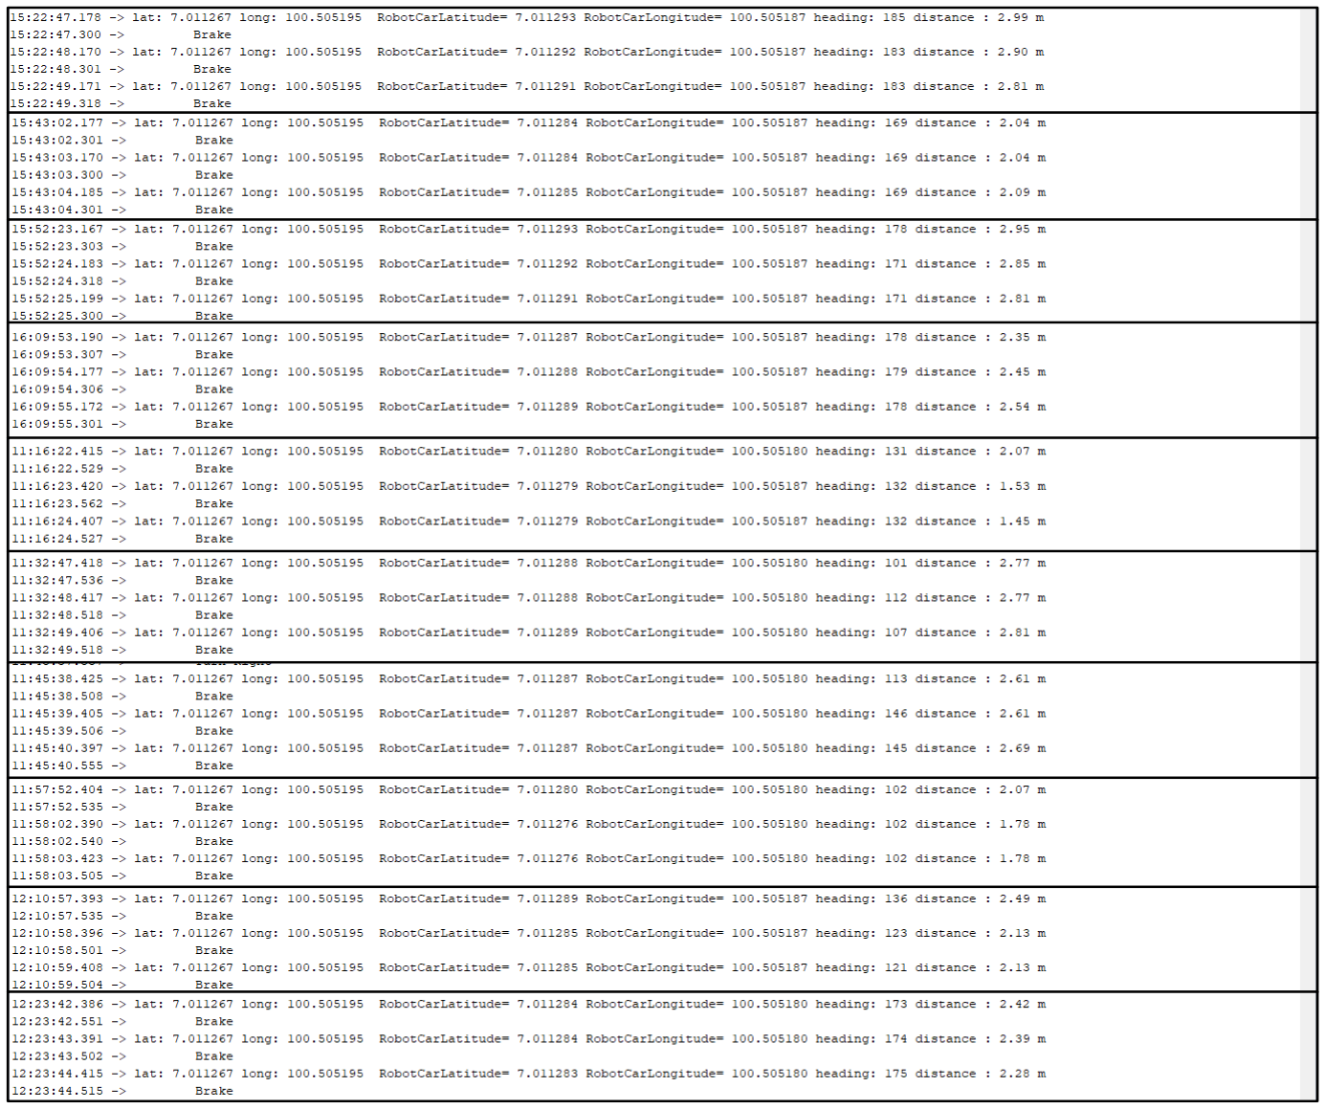
[picture p48: figure]

รูปที่ 25 ผลจากการทดลอง 10 ครั้ง

จากการทดลอง ระยะห่างเฉลี่ยระหว่างพิกัดเป้าหมายกับพิกัดที่หุ่นยนต์เคลื่อนที่ไปถึงทั้ง 10 ครั้ง อยู่ที่ 2.390 เมตร

### 4.3.2 อุปสรรคในการพัฒนา

ในครั้งแรก ได้ก าหนดให้ความคาดเคลื่อนของพิกัดที่หุ่นยนต์เคลื่อนที่ไปถึงเป็น 1 เมตรเพื่อจะ ให้เข้าใกล้กับพิกัดเป้าหมายมากที่สุด ปรากฎว่า เมื่อหุ่นยนต์เคลื่อนที่ไปถึงพิกัดเป้าหมายแล้วช่วงเวลา หนึ่ง ก็จะหาเส้นทางในการเคลื่อนที่ไปยังพิกัดเป้าหมายใหม่อีก เนื่องจากค่าความแม่นย าของ GPS module นั้นอยู่ที่ 2.5 เมตร

### 4.3.3 แนวทางการแก้ปัญหา

ก าหนดให้ความคาดเคลื่อนของพิกัดที่หุ่นยนต์เคลื่อนที่ไปถึงเป็น 3 เมตร เพื่อให้อยู่ในระยะ ของพิกัด GPS ที่ทีความแม่นย าภายในระยะ 2.5 เมตร
ความก้วหน้า 4 พัฒนาโปรแกรมเพื่อให้หุ่นยนต์สามารถหลบสิ่งกีดขวางได้

### 4.4.1 รายละเอียดการพัฒนา

ใช้ ultrasonic sensor 3 ตัวติดตั้งไว้มุมซ้าย ขวา และตรงกลางบริเวณด้านหน้าของหุ่นยนต์ เพื่อใช้ในการตรวจจับวัตถุ หากเซ็นเซอร์ตัวใดตัวหนึ่งตรวจจับเจอวัตถุในระยะ 50 เซนติเมตร จะ ควบคุมให้หุ่นยนต์เลี้ยวหลบสิ่งกีดขวา ทิศทางของการเลี้ยวนั้นจะขึ้นอยู่กับว่าเซ็นเซอร์ตัวใดตรวจจับ เจอวัตถุ หากเซ็นเซอร์ทางขวาตรวจเจอก็จะแล้วซ้าย หากเซ็นเซอร์ตรงกลางหรือทางซ้ายตรวจเจอก็ จะเลี้ยวขวา

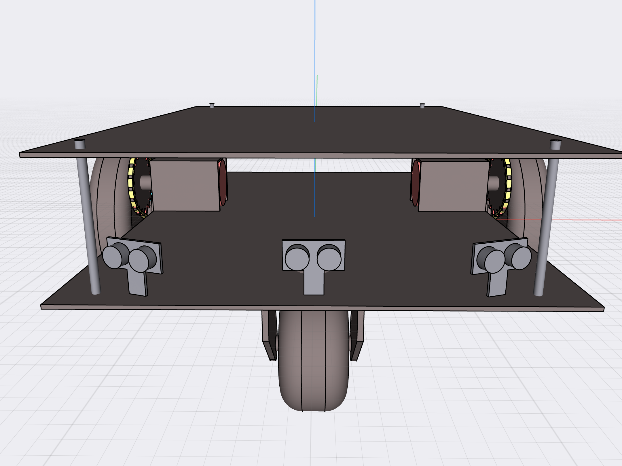
[picture p49: figure]

รูปที่ 26 ภาพจ าลองการติดตั้ง ultrasonic sensor


รูปที่ 27 การติดตั้ง ultrasonic sensor

### 4.4.2 อุปสรรคในการพัฒนา

เนื่องจาก GPS module อัพเดทข้อมูลพิกัดช้ากว่าการตรวจจับวัตถุของ ultrasonic sensor ท าให้การตรวจจับวัตถุช้ากว่าที่ควรจะเป็น เพราะยังติดการท างานของ GPS module ส่งผลให้ หุ่นยนต์หลบสิ่งกีดขวางได้บางครั้ง คือในกรณีที่การอัพเดทพิกัดและตรวจจับเจอวัตถุพอดี

### 4.4.3 แนวทางการแก้ปัญหา

ใช้ interrupt แทนการใช้if else เช็คเงื่อนไขการท างานของ ultrasonic sensor ในการ ตรวจจับวัตถุ หากเซ็นเซอร์มีการเปลี่ยนแปลง จะขัดจังหวะการท างานของโปรแกรม ไปท าตามค าสั่ง ในฟังก์ชันของ interrupt service routine แทน และหากมีวัตถุอยู่ในระยะที่ก าหนด จะควบคุมให้ หุ่นยนต์เลี้ยวหลบสิ่งกีดขวาง

บทที่5
สรุป
สรุปผลการด าเนินการ
1. พัฒนาอินเตอร์เฟซส าหรับการก าหนดพิกัดเป้าหมายให้หุ่นยนต์
2. การส่งข้อมูลระหว่าง Arduino และ Nodemcu
3. หาค่าความคาดเคลื่อนของพิกัด
ปัญหาและอุปสรรค
1. Wi-Fi ของมหาวิทยาลัยที่เป็บแบบ 802.1x ท าให้ค่อนข้างล าบากต่อการเชื่อมต่อgกับ เครือข่ายอินเตอร์เน็ต
2. datastrem ตัวแปรประเภท double ของ blynk มีข้อจ ากัดในการป้อนต าแหน่งทศนิยม ได้เพียง 5 หลักเท่านั้น แต่พิกัดละติจูดและลองจิจูดที่ใช้ในโครงงานนนี้ใช้ทศนิยม 5
ต าแหน่ง
3. ข้อจ ากัดของตัวแปรประเภท float ที่ใช้ในการเก็บค่าในเรื่องของขนาดข้อมูลและความ แม่นย าของต าแหน่งทศนิยม
4. พิกัดละติจูดและลองติจูดที่ได้รับจะสลับต าแหน่งกันและค่าพิกัดคาดเคลื่อน
5. เมื่อหุ่นยนต์เคลื่อนที่ไปถึงพิกัดเป้าหมายแล้วช่วงเวลาหนึ่ง ก็จะหาเส้นทางในการเคลื่อนที่ ไปยังพิกัดเป้าหมายใหม่อีก
6. GPS module อัพเดทข้อมูลพิกัดช้ากว่าการตรวจจับวัตถุของ ultrasonic sensor

### บรรณานุกรม

[1] Sunrobotics. 2020. BellaBot หุ่นยนต์บริการ (Service Robot) หุ่นยนต์แมวน้อยเสิร์ฟอาหาร ถูกออกแบบมาให้เหมือนเเมวน้อยน่ารัก cute สุดๆ. สือค้นเมื่อ 9 มกราคม 2564,
จาก https://www.sunrobotics.co.th/th/articles/202731-bellabot-หุ่นยนต์บริการ-(-service-robot-)-หุ่นยนต์แมวน้อยเสิร์ฟอาหาร-ถูกออกแบบมาให้เหมือนเเมวน้อยน่ารัก-cute-สุดๆ
[2] global5thailand. 2006. ความรู้ทั่วไปเกี่ยวกับ GPS. สืบค้นเมื่อ 9 มกราคม 2564,
จาก https://global5thailand.com/thai/gps.htm
[3] Garmin ประเทศไทย. (ม.ป.ป). GPS คืออะไร. สืบค้นเมื่อ 9 มกราคม 2564,
จาก https://www.garmin.com/th-TH/aboutgps/
[4] iot.codemobile. 2561. GY-NEO6MV2 GPS module NEO6MV2 with GPS Antenna. สืบค้นเมื่อ 15 ก.พ. 2564, จาก http://www.iot.codemobiles.com/product/296/gy-neo6mv2-gps-module-neo6mv2-with-gps-antenna
[5] apiset. 2557. Ultrasonic Sensor Module (HC-SR04) 5V สือค้นเมื่อ 15 ก.พ. 2564,
จาก https://www.arduitronics.com/product/20/ultrasonic-sensor-module-hc-sr04-5v
[6] Analogread. 2564. GY-273 3-axis Compass Module (HMC5883L) สืบค้นเมื่อ 28 ก.พ. 2564, จาก https://www.analogread.com/product/446/gy-273-3-axis-compass-module-hmc5883l
[7] Honeywell. 2563. 3-Axis Digital Compass IC HMC5883L สืบค้นเมื่อ 27 สิงหาคม 2565, จาก
https://cdn-shop.adafruit.com/datasheets/HMC5883L_3-Axis_Digital_Compass_IC.pdf
[8] Arduino4. 2564. BTN7960 BTS7960 43A Current Limiting High-Power H-Bridge DC Motor Drive Module โมดูลขับ Motor DC สืบค้นเมื่อ 28 ก.พ. 2564, จาก https://www.arduino4.com/product/844/btn7960-bts7960-43a-current-limiting-high-power-h-bridge-dc-motor-drive-module-โมดูขับ-motor-dc
[9] LungMaker. 2563. การใช้งานบอร์ด Arduino MEGA 2560 เบื้องต้น. สืบค้นเมื่อ 15 ก.พ. 2564, จาก http://www.lungmaker.com/arduino-mega-2560-การใช้งาน/
[10] เจ้าของร้าน. 2561. NodeMCU ESP8266 / ESP8285 Arduino #1 ESP8266 คือ. สืบค้นเมื่อ 15 ก.พ. 2564, จาก https://www.allnewstep.com/article/30/nodemcu-esp8266-esp8285-arduino-1-esp8266-คือ
[11]Analogread, มปป. DC-to-DC Step Down LM2596 Module (3A) โมดูลลดแรงดันไฟฟ้า จ่ายกระแสได้สูงสุด 3A สือค้นเมื่อ 24 กันยายน 2565, จาก https://www.analogread.com/product/254/dc-to-dc-step-down-lm2596-module-3a-โมดูลลดแรงดันไฟฟ้า-จ่ายกระแสได้สูงสุด-3a-สต็อกไทยส่งไว
[12] Myarduino. 2563. บทความ Arduino เบื้องต้นแบบละเอียด. สืบค้นเมื่อ 9 มกราคม 2564, จาก https://www.myarduino.net/article
[13] Ermi Media's, Syufrijal and Muhammad Rif'an. 2019. Internet of Things (IoT): BLYNK Framework for Smart Home สืบค้นเมื่อ 17 กันยายน 2565, จาก https://knepublishing.com/index.php/Kne-Social/article/view/4128/8495#info
