DreamPawaret/GPS-Mobile-Robot-Project/project/รายงานความก้าวหน้า/midterm/Presentation_Project2_Midterm.pdf

# GPS MOBILE ROBOT

ห

่
น

ุ

## ยนตเ

์

คล

ื

่

## อนท

ี

่

## ควบคม

ุ

ด

้

## วยระบบ GPS

Pawaret Pinkaew 6010110680 Advisor : Asst.Prof.Dr.Thanate Khaorapapong
1

## ประโยชน

์

## ของห

่
น

ุ

## ยนต

์

### ช่วยให

้

### ทำ งำนได

้

### เรว

็

ข

ึ

น

้
ได้งานเยอะขึ้นในเวลาเท่าเดิม

ม

ี

### ควำมผ

ิ

### ดพลำดน

้

อย
สามารถลดสินค้าที่ไม่ผ่านเกณฑ์ได้ในงานผลิต

### ท ำงำนต่อเน ื่องได

้

เป็

### นเวลำนำน

ในขณะที่มนุษย์ต้องการการพักผ่อน

### ลดต

้

### นทน

ุ

### ในกำรผล

ิ
ต
ทั้งเรื่องของเวลา และความเสี่ยงจากการสูญเสีย

### ลดควำมเสี่ยงจำกกำรท ำงำนที่อันตรำย

เช่นทํางานที่ในที่ที่มีอุณหภูมิสูง

# ที่มำและควำมส ำคัญ

2

# แผนกำรดำ

เน

ิ
นงำน | Project II

พัฒนาหุ่นยนต์และเขียนโปรแกรม สําหรับควบคุม Microcontroller

ทดลองและวัดผลการทดลอง

สรุปผลการทดลอง

จัดทําเล่มโครงงาน

มิ.ย. | ก.ค. | ส.ค. | ก.ย. | ต.ค.

3

# โครงสรำ

้

# งของห

่
น

ุ

# ยนต

์

4

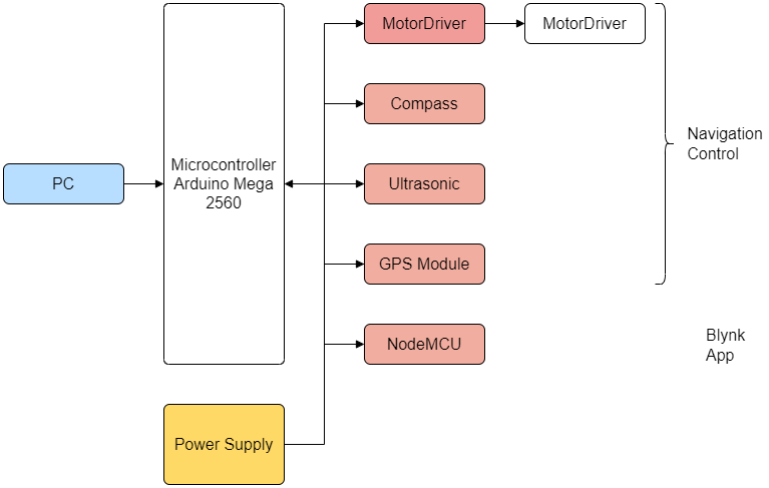
[picture p50: figure]

# กำรท ำงำนของระบบ

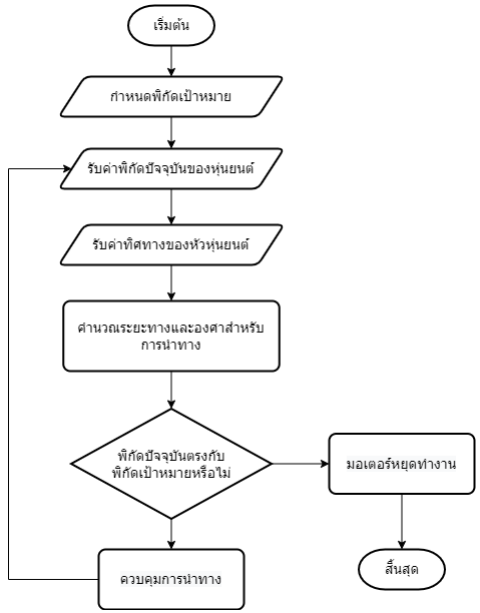
[picture p51: figure]

5

# ปรบ

# ัปรง

ุ

# โครงสร

้

# ำงของห

่
น

ุ

# ยนต์

6

# ปรบ

# ัปรง

ุ

# โครงสรำ

้

# งของห

่
น

ุ

# ยนต

์

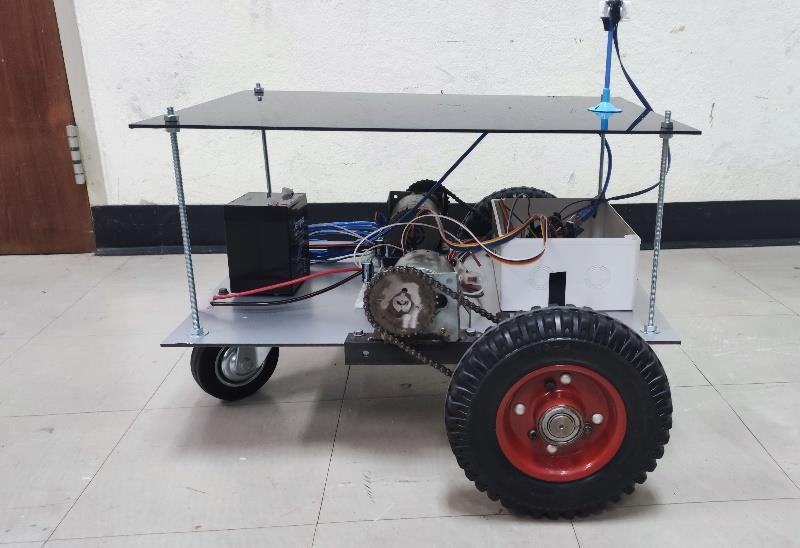
[picture p52: figure]

เปลี่ยนโครงสร

้

ำงของหุ่นจำกไม
้

เป็

น
แผ่นอลูมิเนียม และเพิ่มหลงัคำของห่นุ ยนต์ให้สูง จำกตัวฐำน 20 เซนติเมตรด
้

วยแผ่นอะคริลิคเพ
ื่อ
ป้

องกนั ส่วนวงจรและควำมเรียบร ้

อย

7

# ทดสอบกำรน ำทำงและกำรเคลื่อนที่

8

# ทดสอบกำรน ำทำงและกำรเคลื่อนที่

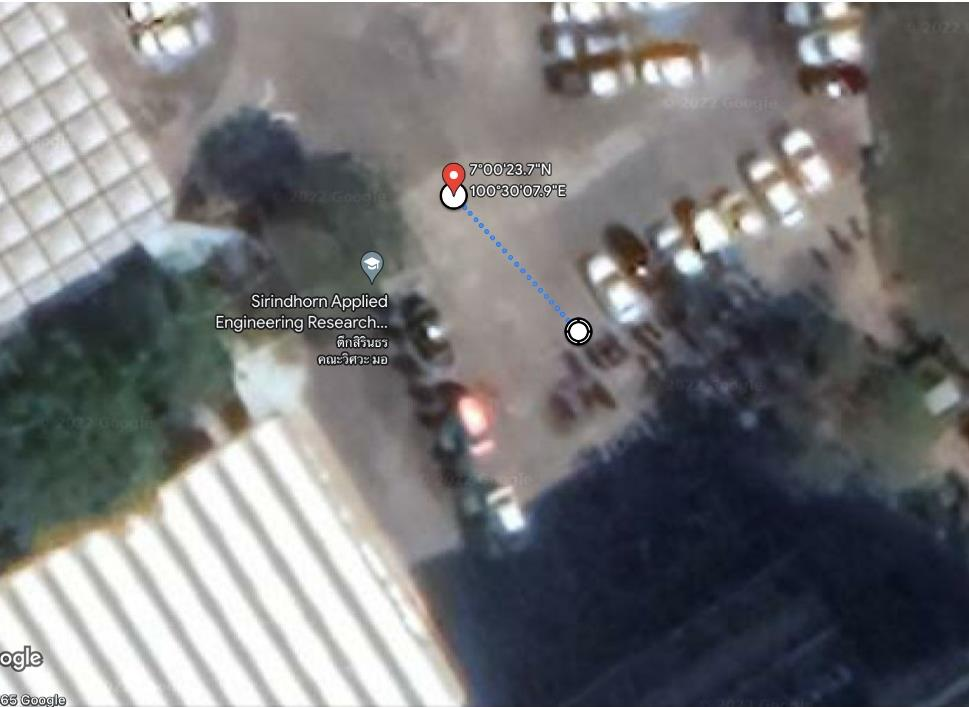
[picture p53: figure]

น ำห่นุ ยนตไ์ปทดสอบกำรน ำทำงและกำรเคล ื่อนทในี่
บริเวณหน
้

ำอำคำรวิจยัวิศวกรรมประยกุ ตส

์ิรินธร
เล

ื

อกพิกดัเป้

ำหมำยโดยดคู ่ำละติจดู และลองจิจดจำก ู google map จำกนัน้ กำ หนดพิกดัที่ต ้

องกำรให

้
ห่นุ ยนตเ
์

คล

ื่อนที่ลงไปในโปรแกรมผ่ำนคอมพิวเตอร์

9

# ทดสอบกำรน ำทำงและกำรเคลื่อนที่

10

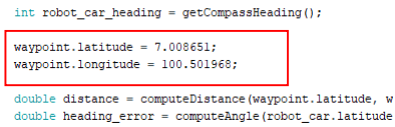
[picture p54: figure]

## กำรกำ

## หนดพ

ิ
กด

ั

เป้

## ำหมำยให

้

ห

่
น

ุ

## ยนต์

จะก ำหนดลงไปในโปรแกรมโดยตรง โดยก ำหนดเป็ น พิกดัละติจลู และลองจิจดู

# ทดสอบกำรน ำทำงและกำรเคลื่อนที่

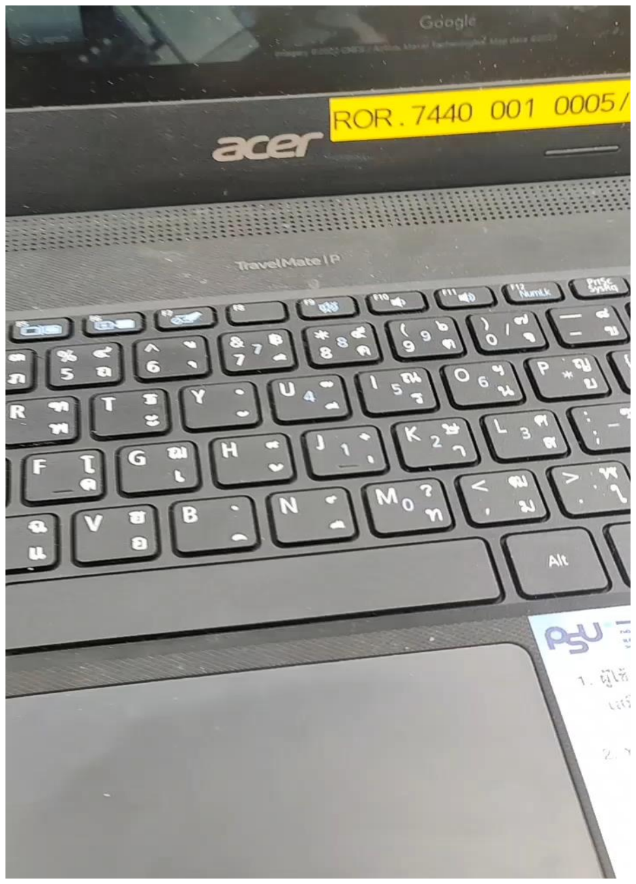
[picture p55: figure]

11

ผลจำกกำรทดสอบ ห่นุ ยนตส
์

ำมำรถเคล

ื่อนที่ไปยงั
พิกดัที่กำ หนดได
้

แต่กำรเคล

ื่อนที่ยงัไม่รำบเรียบ

# สรุป

สรุปผลการดําเนินการ
1. พัฒนาโครงสร้างของหุ่นยนต์ให้มีความแข็งแรงขึ้นหามุมที่หุ่นต้องหมุนไปยังพิกัดจุดหมาย
2. หุ่นยนต์สามารถเคลื่อนที่ไปยังพิกัดที่กําหนดได้

งานที่จะดําเนินการต่อไป
1. พัฒนาโปรแกรมสําหรับกําหนดพิกัดเป้าหมายให้หุ่ยนต์
2. กรองค่าละติจูดและลองจิจูดจาก GPS เพื่อลดความคาดเคลื่อนของตําแหน่ง
3. พัฒนาโปรแกรมเพื่อให้หุ่นสามารถหลบสิ่งกีดขวางได้
12

ปัญหาและอุปสรรค
1. ความคาดเคลื่อนในการรับค่าพิกัด GPS
2. การกําหนดพิกัดเป้าหมายให้หุ่นยนต์ยังใช้การกําหนดลงไปในโค้ดโดยตรง
3. การเคลื่อนที่ของหุ่นยนต์ยังไม่ค่อยราบรื่น มีการเหวี่ยงเล็กน้อย

# THANK YOU

# ขอบคุณครับ

13
