DreamPawaret/GPS-Mobile-Robot-Project/project/ส่วนต่างๆของรถ การต่อกระกอบ การต่อสายไฟ.pdf

# ร้าน o.ไหล่ยนต์

## ✓ n ซื้อฟืโซ่ ราวลี้น 4 ชิ้น

เอาไปเจาะ

ใส่มอเตอร์ 2 ชิ้น รูเล็ก 8mm | }รูไได้ตามกำหนด ย _ ใส่ล้อรถ 2 ชิ้น รูใหญ่ 20mm

## ร้านเหล็งต้

## ✓ 1.ซื้อแผ่นเพลทกลม 2 แผ่นขนาดเท่โครง า ของล้อ ในแคนล้อ ¢ ⁹⁸.5mm

✓ 2. เพลาขนาด 1นี้ว เส้นผ่าศูนย์กลาง ยาว50cm.

g

ใช้ทำเพลาล้0 2ข้าง | \m ใช้ทำแป้น → เอไปเชื่อมกับเฟืองที่ ล้อรถ | ม
รกi.กว้าง 35 m.
เอามาเพื่อทำแป้นยึดกับเฟืองด้วย ④

## โรงกลึง Cอยู่ ก่อนถึงร้านอ.อะไหล่ยนก็

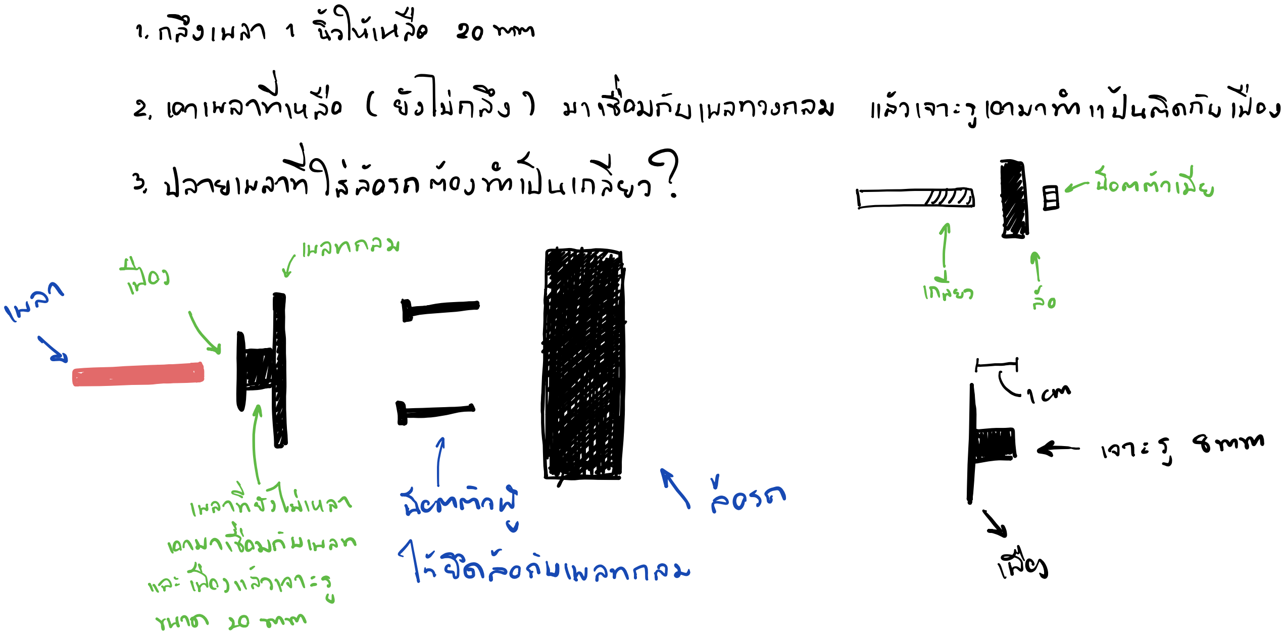
[picture p56: figure]
กลึงเพลา า นี้ให้เหลือ 20mm; 2.เอาเพลาที่เหลือCยัไงม่กลึง มาเชื่อมกับเพลทวงกลม แล้วเจาะรูเอามาทำแป้นติดกับเฟือง; 3.ปลายเมลที่ใส่ล้อรถต้องทำเป็นเกลียว?; irxoe ฅู๊µ←น็อตตัวเมีย; µmm.........; Hkktsrr.om; เพลาที่ยัไงม่ เหลา น็อตตัวผู้; ม เอามาสื่อมกับพล; ไงยึดล้อกับเพลทกลม; ลง และสองแล้วเจาะรู ขนาด ห mm
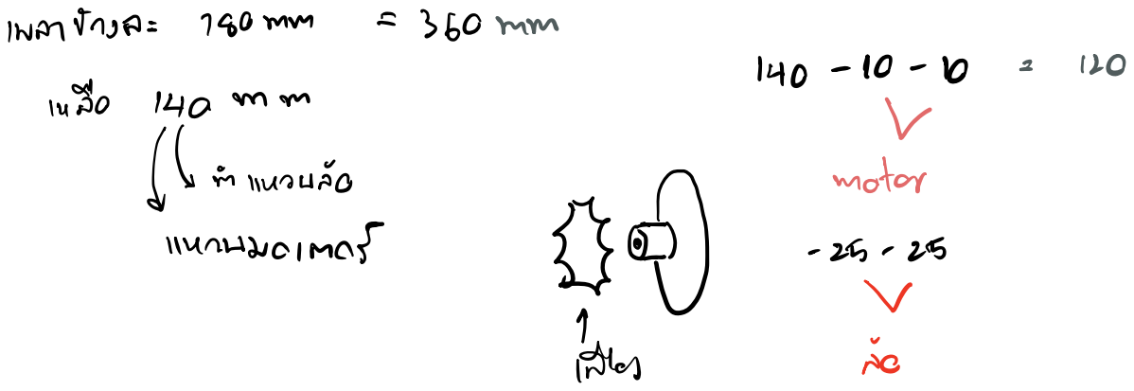
[picture p57: figure]
เพลาข้างละ 780mm = 360mm; เหลือ 140 mm; fbทำแหวนล้อ; motor; แหวนมอเตอร์; 3gED 25 25

2 ชิ้น

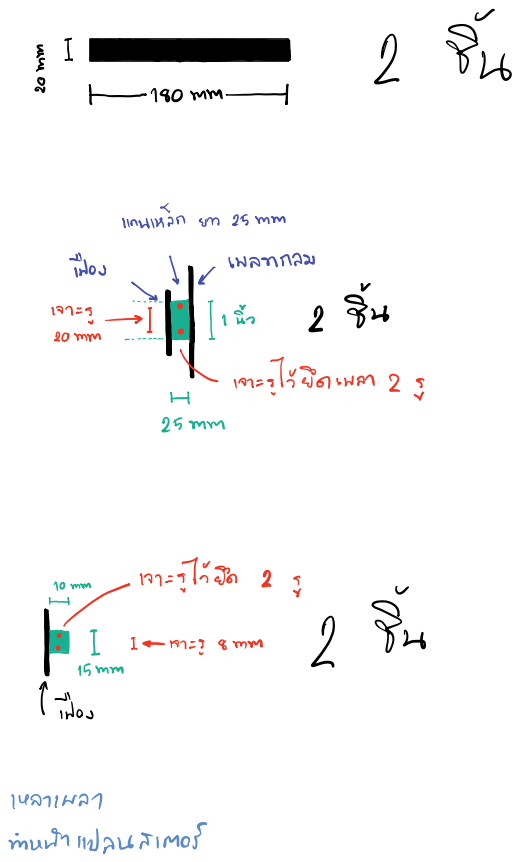
[picture p58: page 2]
Inaarmmnoansnaaootnnrseora; แกนแกร็กยาว 25mm; วืฟอง; \|, เพลทกลม; i.÷😐Ekim 2 ชิ้น ๆน; เจาะไ รูว้ยึดเพลา 2 รู; เหลาเพลา ทำหน้าแปลนสเต ย์

เกินทน | เส้นขาว
motor | motor

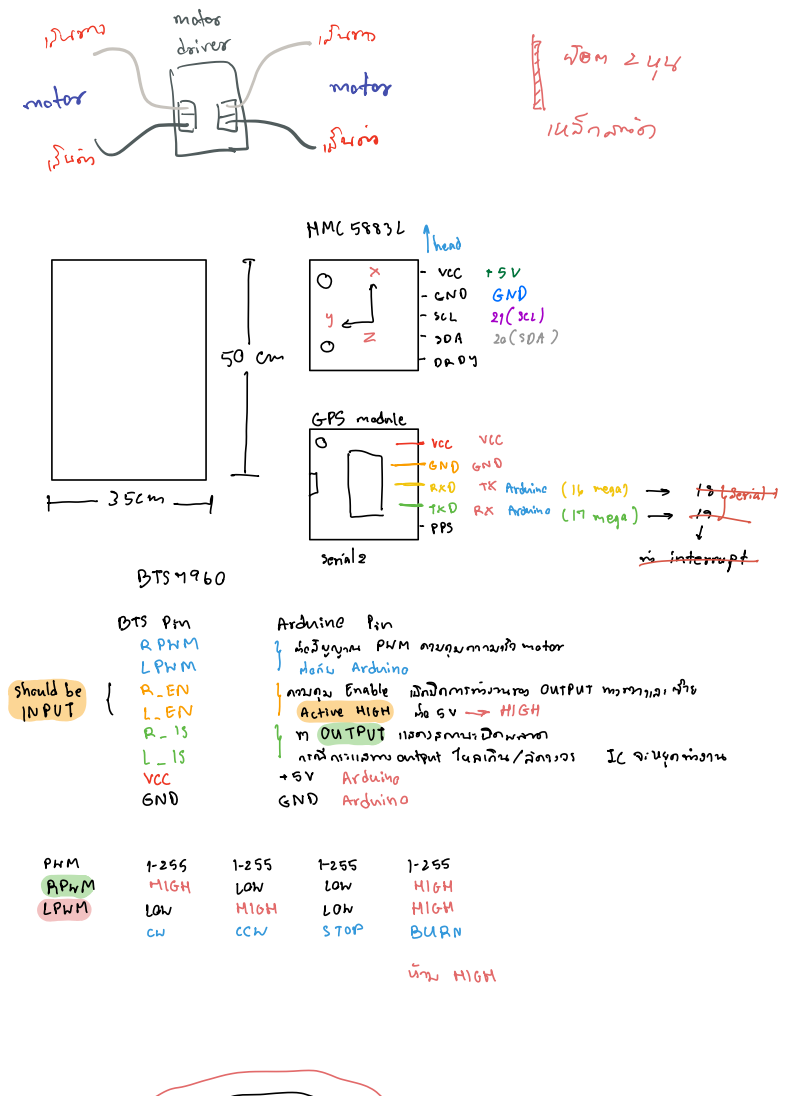
[picture p59: page 3]
ร ติฐื่ ¥ แสนต่; เหล็กสห้ต; HML5883l |head; GND GND; 2 sell; sDA 2อ SDA; napy t GPSmoduleสี๋ noooNDยมก ะะ; 35<many; _pps; serial2; niinterruptrn; BTS Pin; Ardnine Pin; RPพM LPWM; shouldbe; INPUT; VCC; Arduino; pwM; RPwM; low; Mloมา; HIGH HIGH; ccw; ออก BURN

} ต่อสัญญาณ Pwmควบคุมความารัวmota
คอญื้มีญํ๊หื่ำ

นิกปิดการทำงานของOUTPUTทางขวาและซ้าย

→5ขูณีกระแสทางantpntไหลเกิน ลัดวเวร 2Cจะหยุดทำงาน
GND Arduino

รื๊

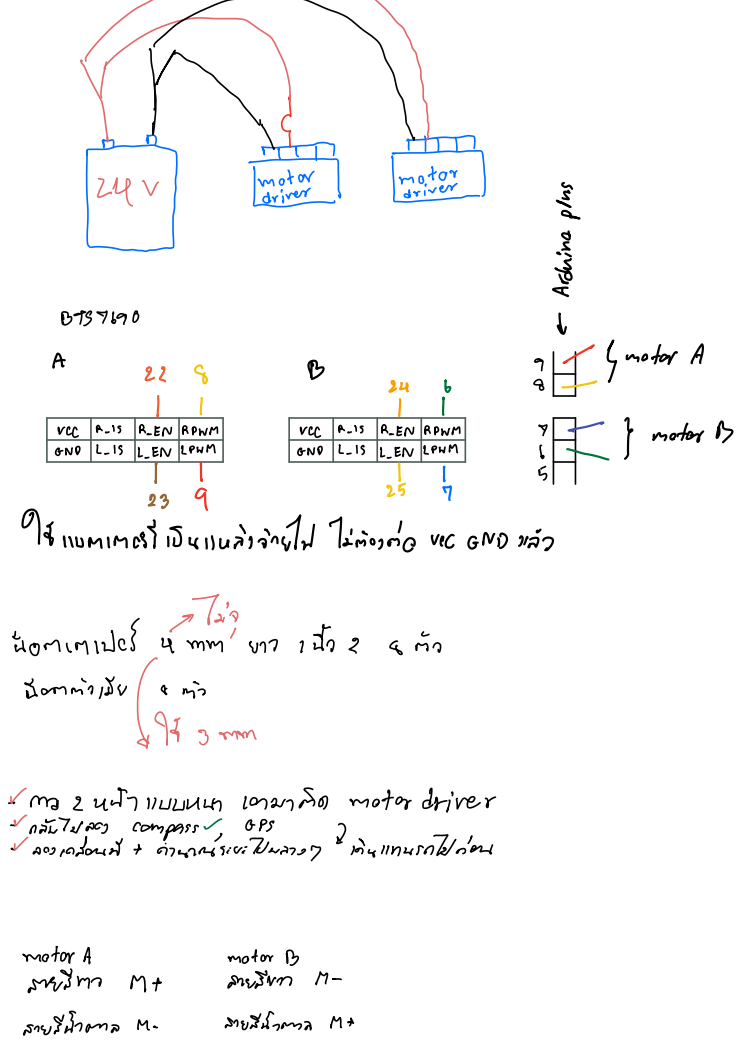
[picture p60: page 4]
BTS7690; g=}m.twA; ÷iii. ต๊; นี่ นาตัวเมีย 8 ตัว โรง mm; motor B สายสีขาว M; สายสีน้ำตาล M

ใช้แบตเตอรี่เป็นแหล่งจ่ายไปไม่ ต้องต่อ uecoNDแล้ว

✓การ 2หทำแบบหนา เอามาติด motordriver
✓กลับไปลอง compassT GPS
✓ลแเคลื่อนที่ t คำนวณระยะไพลางๆ

เดินแทนรถไก่อน

5ก

# 3 ะ รํ๋นื๊ณื๊ญื๋ฐื๋ nodemcu

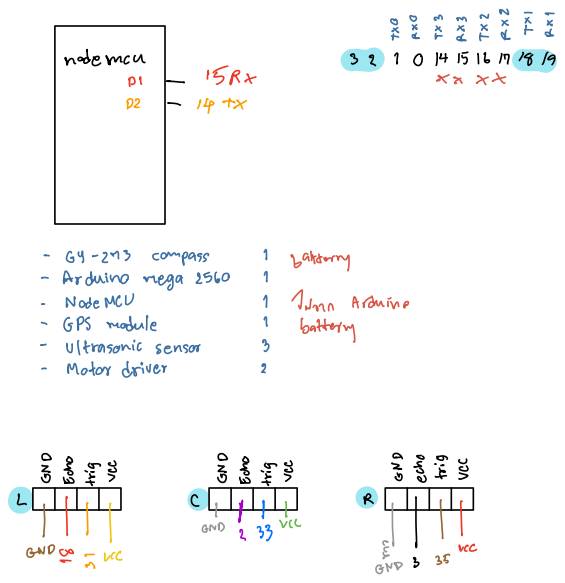
[picture p61: page 5]
inain หํ๊w า ฒๆ; NodeMCU; GPS module; battery; Motordgiug; Aranin.; ultrasonicsensor; แรง; อบD=ก็uc
