DreamPawaret/GPS-Mobile-Robot-Project/project/project_from_drive/prototype/dbh-motor-driver/dbh-motor-driver.ino

/* 
DBH-1 Motor Driver Library
Written and debugged by David Williams (Thevolget). 
All rights reserved.

This library is designed to be used with the DBH-1 Series of motor drivers that 
can be found on EBay or Aliexpress (usually under the name of 'wingxine').  

This library will assume the following pins are used by default:

  ENA - Pin 2
  ENB - Pin 4
  IN1A - Pin 3 (Input for motor A - needs to be PWM pin)
  IN1B - Pin 5 (Input for motor B - needs to be PWM pin)
  IN2A - Pin 6 (Input for motor A - needs to be PWM pin)
  IN2B - Pin 9 (Input for motor B - needs to be PWM pin)
  CTA - Analog Pin 0 (Optional)
  CTB - Analog Pin 1 (Optional)
  
  Pins CTA and CTB are pins for reporting the current draw of the driver back to 
  the microcontroller.  The driver outputs a analog value based on current draw.
  
  EN1 and EN2 are pins for enabling the driver's output to the respective motor.
  
  IN1A and IN2A (as well as IN2A and IN2B) are the inputs for motor A (and B 
  respectively).  When IN1A is driven LOW and IN2A is provided a PWM signal, the 
  motor will go in reverse.  When IN1A is provided a PWM signal and IN2A is driven 
  LOW, the motor will go forward.

  The driver requires a maximum duty cycle on the PWM input of no more than 98%.  
  Any higher might damage the driver / result in instability.
  
Library usage:

  Option 1:
    DBH1.init();  This will use the default pins
  
  Option 2:
    DBH1.init(IN1A, IN1B, IN2A, IN2B, ENA, ENB, CTA, CTB);    This will define which
      pins are used on the microcontroller.  
  
  Once defined the motor can be controlled by using:
    DBH1.Forward(Motor A PWM value, Motor B PWM value);   Moves both motors forward
    DBH1.Reverse(Motor A PWM value, Motor B PWM value);   Moves both motors reverse
    DBH1.Braking();                     UNTESTED - USE WITH CAUTION
    DBH1.Coasting();                    Disables motor output
    DBH1.ForwardA(PWM value);               Moves Motor A or B at X% speed
    DBH1.ReverseA(PWM value);               Forward or Reverse
    DBH1.ForwardB(PWM value);
    DBH1.ReverseB(PWM value);
    DBH1.DisableA();
    DBH1.DisableB();
    DBH1.BrakeA();                      UNTESTED - USE WITH CAUTION
    DBH1.BrakeB();                      UNTESTED - USE WITH CAUTION
    
    
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
* Neither the name of the copyright holders nor the names of
  contributors may be used to endorse or promote products derived
  from this software without specific prior written permission.

THIS SOFTWARE IS PROVIDED BY THE COPYRIGHT HOLDERS AND CONTRIBUTORS "AS IS"
AND ANY EXPRESS OR IMPLIED WARRANTIES, INCLUDING, BUT NOT LIMITED TO, THE
IMPLIED WARRANTIES OF MERCHANTABILITY AND FITNESS FOR A PARTICULAR PURPOSE
ARE DISCLAIMED. IN NO EVENT SHALL THE COPYRIGHT OWNER OR CONTRIBUTORS BE
LIABLE FOR ANY DIRECT, INDIRECT, INCIDENTAL, SPECIAL, EXEMPLARY, OR
CONSEQUENTIAL DAMAGES (INCLUDING, BUT NOT LIMITED TO, PROCUREMENT OF
SUBSTITUTE GOODS OR SERVICES; LOSS OF USE, DATA, LIFE, OR PROFITS; OR BUSINESS
INTERRUPTION) HOWEVER CAUSED AND ON ANY THEORY OF LIABILITY, WHETHER IN
CONTRACT, STRICT LIABILITY, OR TORT (INCLUDING NEGLIGENCE OR OTHERWISE)
ARISING IN ANY WAY OUT OF THE USE OF THIS SOFTWARE, EVEN IF ADVISED OF THE
POSSIBILITY OF SUCH DAMAGE.  
*/

#include "DBH1.h"

int IN1A = 3;               //Motor controller input IN1(A) - Left Motor
int IN1B = 5;               //Motor controller input IN1(B) - Right Motor
int IN2A = 6;               //Motor controller input IN2(A) - Left Motor  
int IN2B = 9;               //Motor controller input IN2(B) - Right Motor
int ENA = 2;                //Left Motor Enable
int ENB = 4;                //Right Motor Enable
int CTA = 0;                //Current input from driver for (A) - Left Motor
int CTB = 1;                //Current input from driver for (B) - Right Motor

                      //Following defines optional parameters that can be passed

void DBH1::init(byte _IN1A = IN1A, byte _IN1B = IN1B, byte _IN2A = IN2A, byte _IN2B = IN2B, byte _ENA = ENA, byte _ENB = ENB, byte _CTA = CTA, byte _CTB = CTB){
  IN1A = _IN1A;             //Allow pins to be reassigned (requires being called with optional arguments)
  IN1B = _IN1B;
  IN2A = _IN2A;
  IN2B = _IN2B;
  ENA = _ENA;
  ENB = _ENB;
  CTA = _CTA;
  CTB = _CTB;
  pinMode(IN1A, OUTPUT);          //Define pins used as outputs
  pinMode(IN1B, OUTPUT);
  pinMode(IN2A, OUTPUT);
  pinMode(IN2B, OUTPUT);
  pinMode(ENA, OUTPUT);
  pinMode(ENB, OUTPUT);
}

void DBH1::Forward(int _Apwm, int _Bpwm){
  _Apwm = abs(_Apwm);                   //Prevent PWM value from being negative
  _Bpwm = abs(_Bpwm);            
  analogWrite(IN1A, _Apwm);       //PWM to 1st set of inputs
  analogWrite(IN1B, _Bpwm);
  digitalWrite(IN2A, LOW);        //Set 2nd set of inputs LOW for forward movement
  digitalWrite(IN2B, LOW);          
}

void DBH1::Reverse(int _Apwm, int _Bpwm){
  _Apwm = abs(_Apwm);           //Prevent PWM value from being negative                 
  _Bpwm = abs(_Bpwm);          
  analogWrite(IN2A, _Apwm);       //PWM to 2nd set of inputs
  analogWrite(IN2B, _Bpwm);
  digitalWrite(IN1A, LOW);        //Set 1st set of inputs LOW for reverse movement
  digitalWrite(IN1B, LOW);          
}

void DBH1::Braking(){           //Sets all pins HIGH to enable brake
  digitalWrite(ENA, HIGH);      
  digitalWrite(ENB, HIGH);             
  digitalWrite(IN1A, HIGH);
  digitalWrite(IN1B, HIGH);
    digitalWrite(IN2A, HIGH);
  digitalWrite(IN2B, HIGH);         
}

void DBH1::Coasting(){            //Disables motor and allows for free roll
  digitalWrite(IN2A, HIGH);     
  digitalWrite(IN1B, HIGH);
  digitalWrite(IN1A, HIGH);
  digitalWrite(IN2B, HIGH);
    digitalWrite(ENA, LOW);
  digitalWrite(ENB, LOW);
}

int DBH1::GetCurrent(int AnalogPin){    //Reads current draw from driver and outputs back value from 0 - 1023
  int Current = 0;
  Current = analogRead(AnalogPin);
  return Current;
}

void DBH1::ForwardA(int _Apwm){
  _Apwm = abs(_Apwm);
  analogWrite(IN1A, _Apwm);
  digitalWrite(IN2A, LOW);
}

void DBH1::ForwardB(int _Bpwm){
  _Bpwm = abs(_Bpwm);
  analogWrite(IN1B, _Bpwm);
  digitalWrite(IN2B, LOW);
}

void DBH1::ReverseA(int _Apwm){
  _Apwm = abs(_Apwm);
  analogWrite(IN2A, _Apwm);
  digitalWrite(IN1A, LOW);
}

void DBH1::ReverseB(int _Bpwm){
  _Bpwm = abs(_Bpwm);
  analogWrite(IN2B, _Bpwm);
  digitalWrite(IN2A, LOW);
}

void DBH1::DisableA(){
  digitalWrite(ENA, LOW);
}

void DBH1::DisableB(){
  digitalWrite(ENA, LOW);
}

void DBH1::EnableA(){
  digitalWrite(ENA, HIGH);
}

void DBH1::EnableB(){
  digitalWrite(ENB, HIGH);
}

void DBH1::EnableBoth(){
  digitalWrite(ENA, HIGH);
  digitalWrite(ENB, HIGH);
}

void DBH1::DisableBoth(){
  digitalWrite(ENA, LOW);
  digitalWrite(ENB, LOW);
}
