DreamPawaret/GPS-Mobile-Robot-Project/(commit log)

2022-11-01 add more file
    แก้ไขโค้ด และอัพโหลดไฟล์เพิ่มเติม
2022-11-01 แก้ไข main
2022-11-01 เพิ่มไฟล์ การต่อสายไฟ
2022-11-01 add arduino library
